tomverbeure/ball/LED_constraints_overview.png

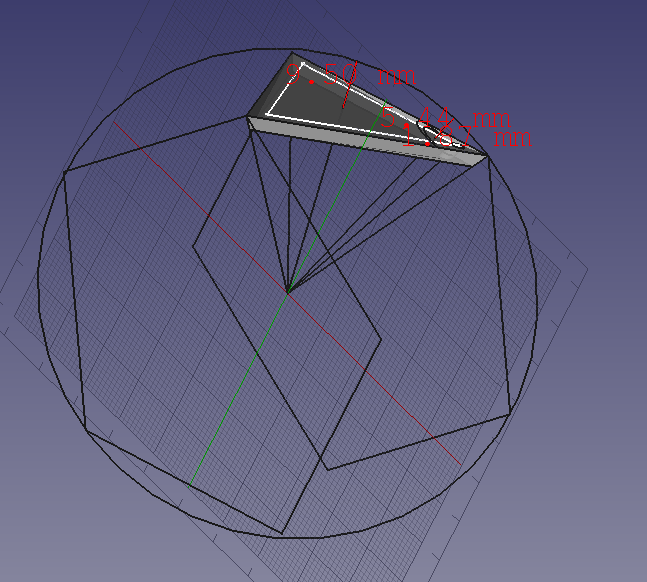
LED_constraints_overview.png
