tomverbeure/ball/LED_height_on_sphere.png

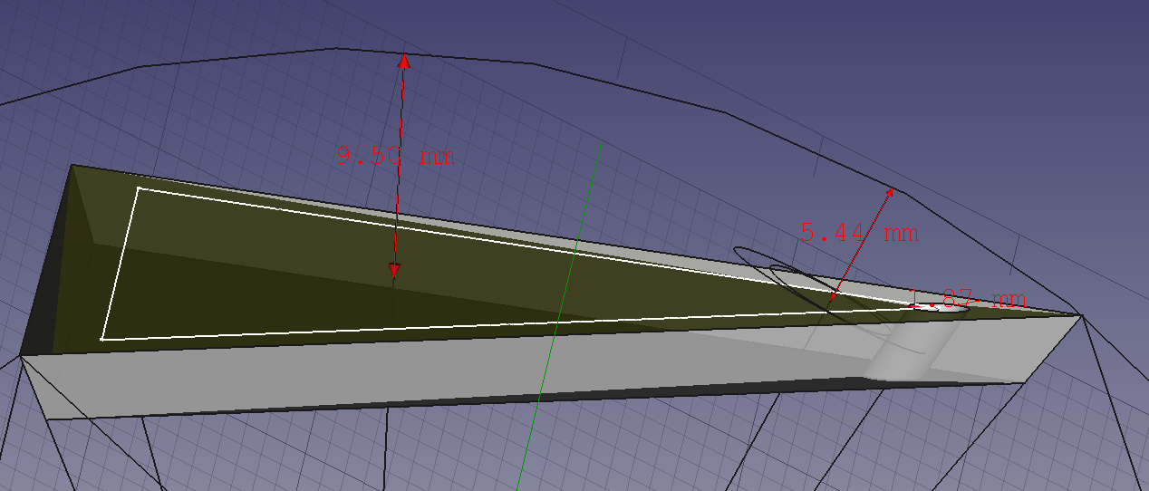
LED_height_on_sphere.png
