tomverbeure/ball/LED_leads_width.png

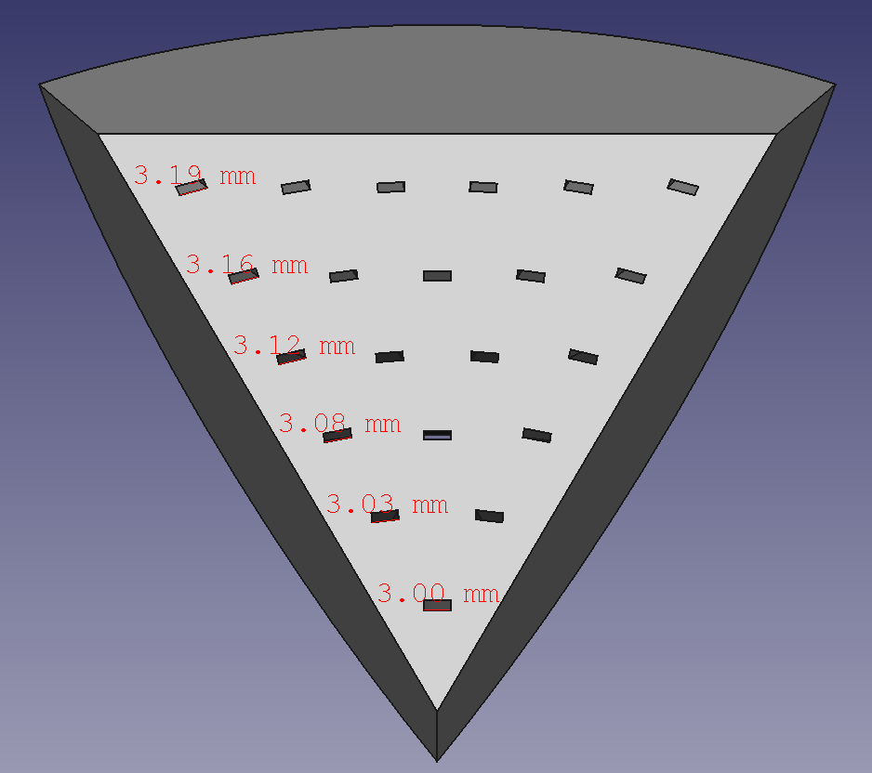
LED_leads_width.png
