tomverbeure/ball/LED_width_on_sphere.png

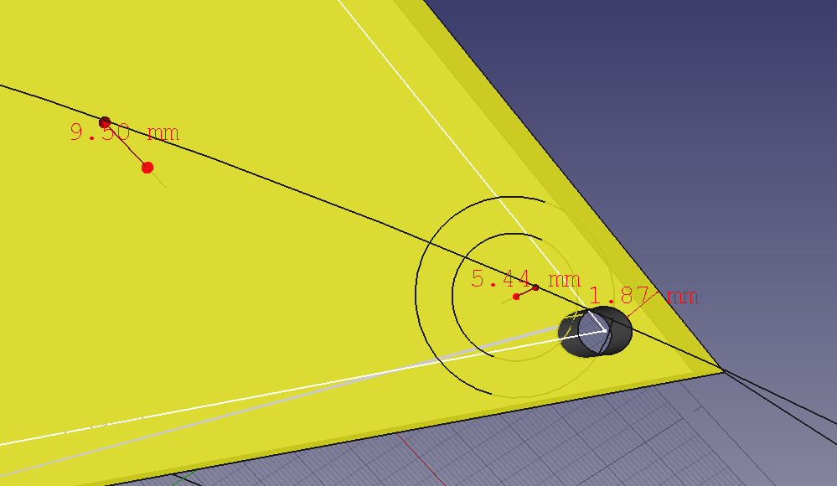
LED_width_on_sphere.png
