tomverbeure/ball/sphere_overall_dimensions.png

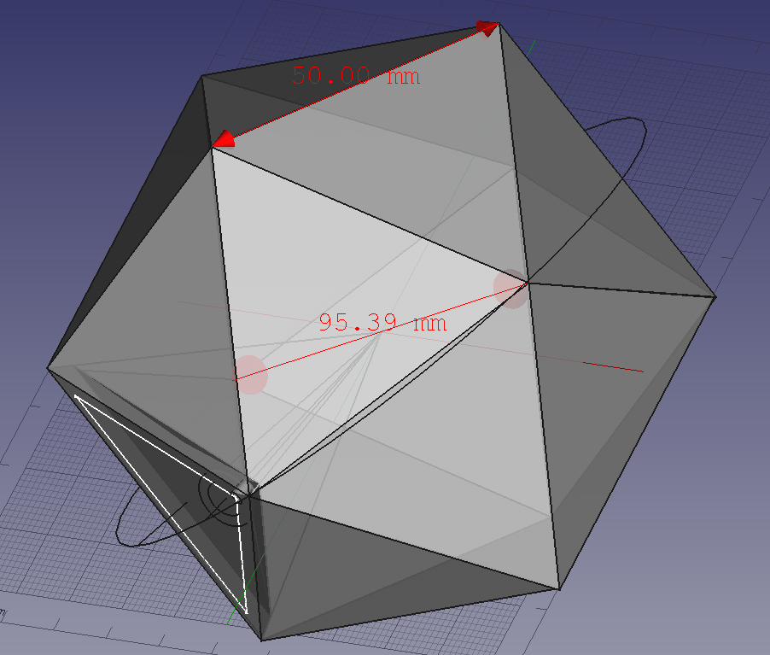
sphere_overall_dimensions.png
