tomverbeure/ball/icosahedron/geodesic_1/assembly2.FCStd

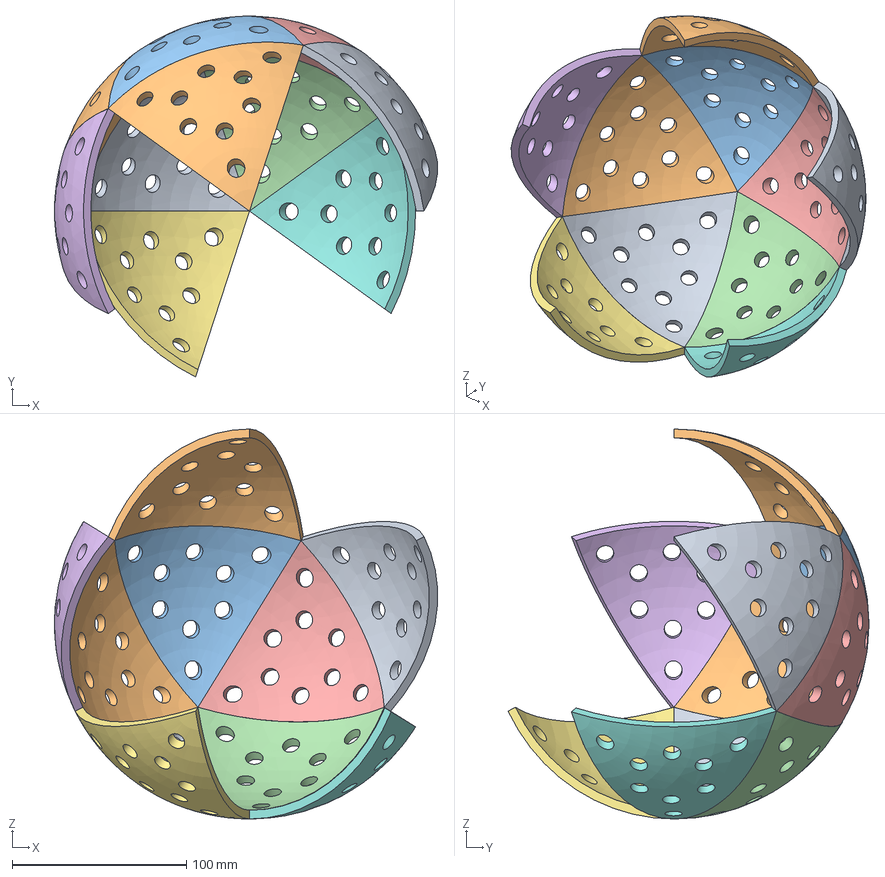
[picture p12: CAD file, 2021-12-22]
icosahedron/geodesic_1/assembly2.FCStd
219.5 x 206.9 x 223.5 mm
test_Body002_001
test_Body002_002
test_Body002_003
test_Body002_004
test_Body002_005
test_Body002_006
test_Body002_007
test_Body002_008
test_Body002_009
test_Body002_010
