tomverbeure/ball/rev1/inner_assembly.FCStd

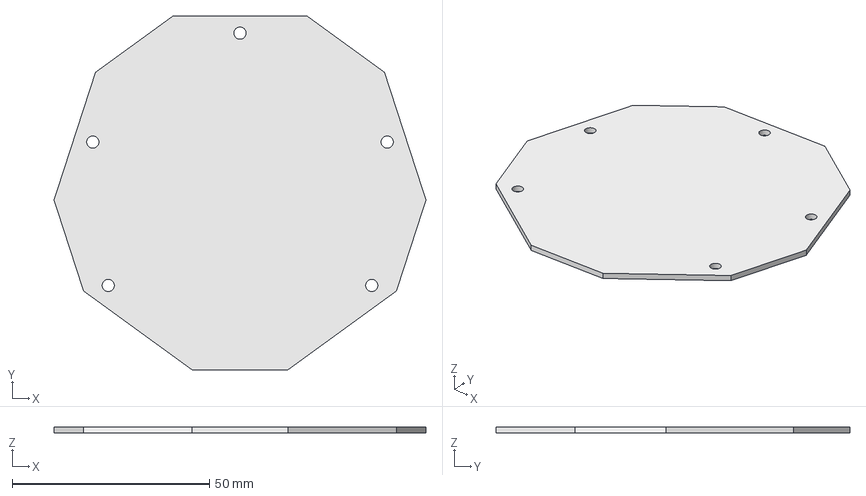
[picture p14: CAD file, 2022-05-01]
rev1/inner_assembly.FCStd
94.4 x 89.8 x 1.60 mm
