tomverbeure/ball/rev1/inner_assembly_PraGa.FCStd

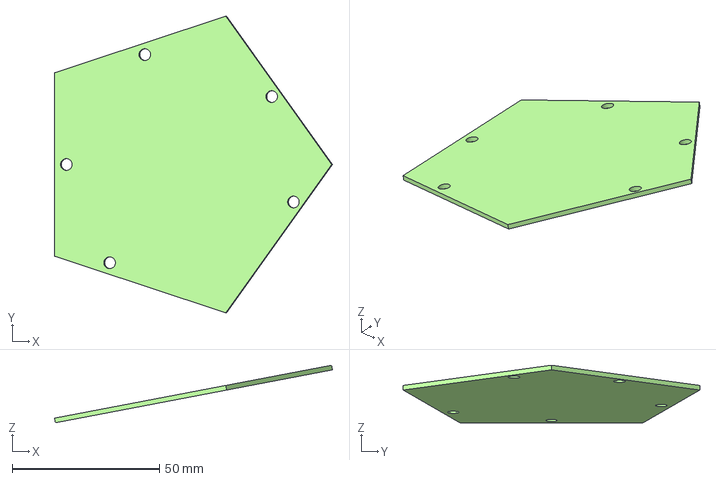
[picture p15: CAD file, 2022-05-01]
rev1/inner_assembly_PraGa.FCStd
94.5 x 100.8 x 19.6 mm
