tomverbeure/ball/icosahedron/Shell_and_PCB_complete.FCStd

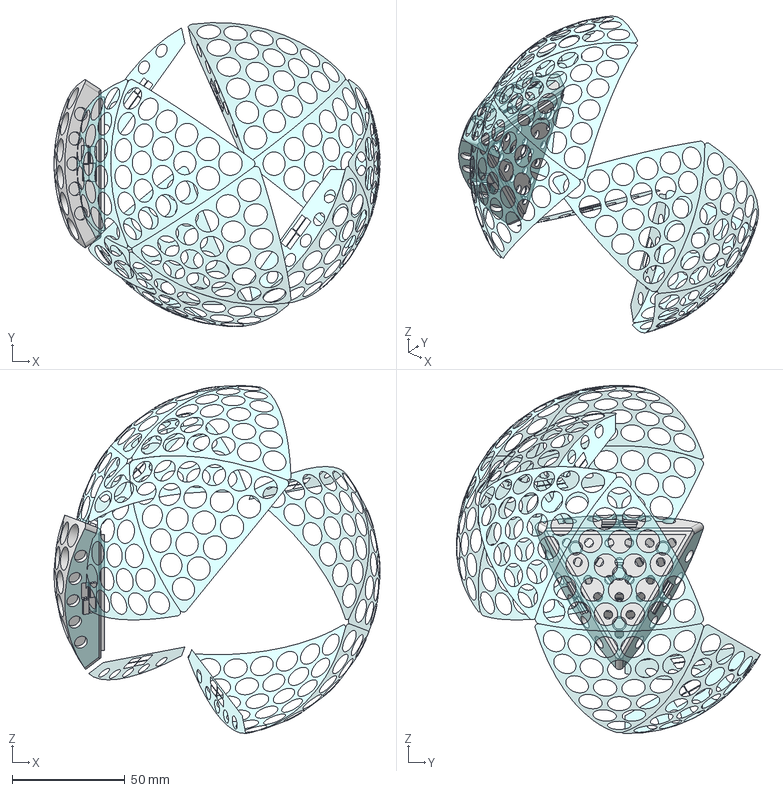
[picture p16: CAD file, 2022-03-06]
icosahedron/Shell_and_PCB_complete.FCStd
144.5 x 134.7 x 154.4 mm
_Element004
_Element005
_Element021
_Element022
_Element023
_Element025
_Element032
_Element040
_Element043
_Element048
_Element053
_Element058
_Element063
_Element064
_Element069
_Element074
_Element079
