tomverbeure/ball/rev1/assembly_a4.FCStd

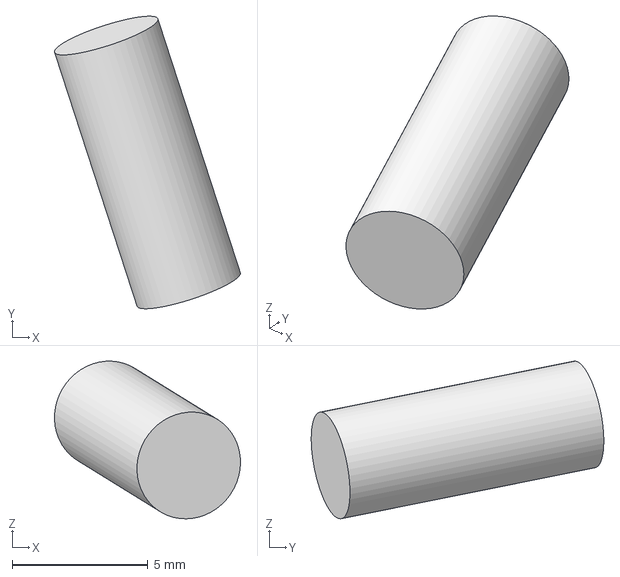
[picture p17: CAD file, 2022-03-27]
rev1/assembly_a4.FCStd
6.84 x 10.8 x 5.80 mm
