tomverbeure/ball/rev1/assembly_a2plus.FCStd

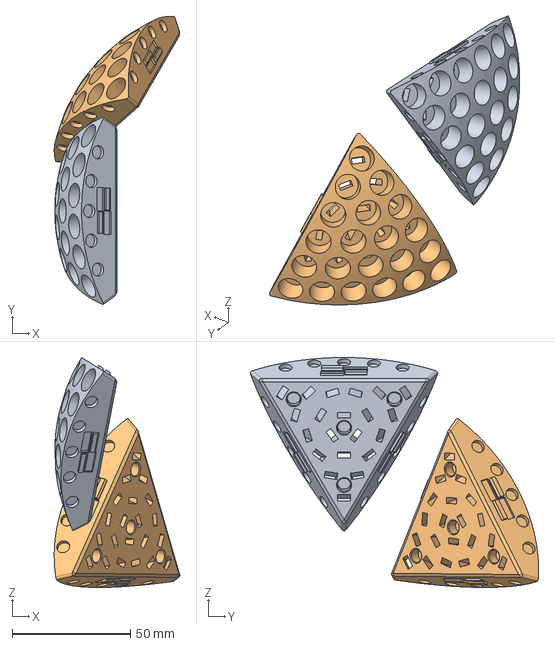
[picture p18: CAD file, 2022-03-27]
rev1/assembly_a2plus.FCStd
53.2 x 122.0 x 97.4 mm
Shell_rev1_001
Shell_rev1_002
