tomverbeure/ball/rev1/ball-1x_shell_full_brim.3mf

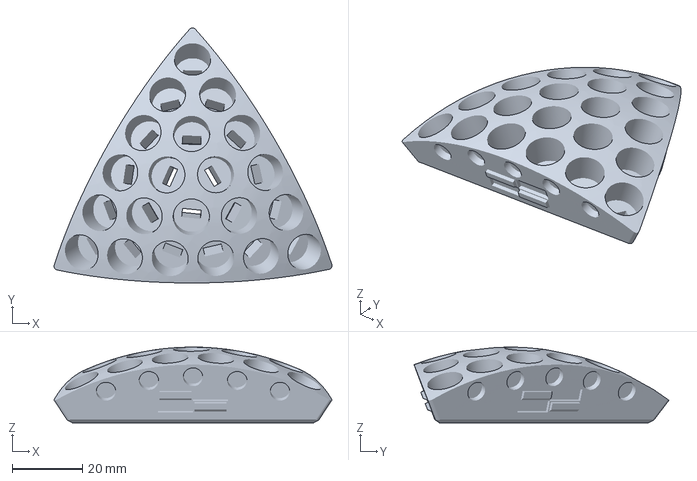
[picture p19: CAD file, 2022-03-27]
rev1/ball-1x_shell_full_brim.3mf
79.4 x 72.8 x 21.6 mm
