tomverbeure/ball/rev1/ball-shell_full.amf

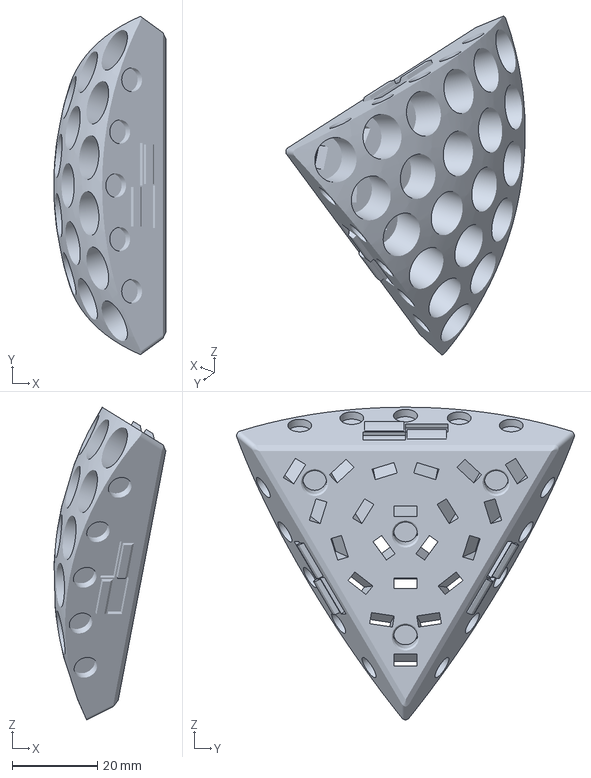
[picture p20: CAD file, 2022-03-13]
rev1/ball-shell_full.amf
26.3 x 79.4 x 73.4 mm
