tomverbeure/ball/rev1/ball-2x_shell_full_brim.3mf

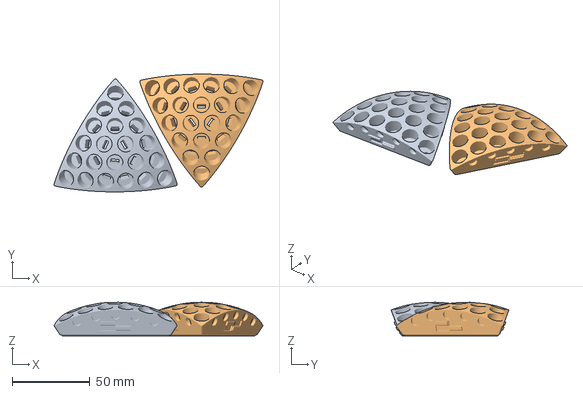
[picture p21: CAD file, 2022-03-13]
rev1/ball-2x_shell_full_brim.3mf
134.6 x 75.9 x 21.6 mm
ball-shell_full.amf
ball-shell_full.amf(1)
