tomverbeure/ball/icosahedron/geodesic_1/test.FCStd

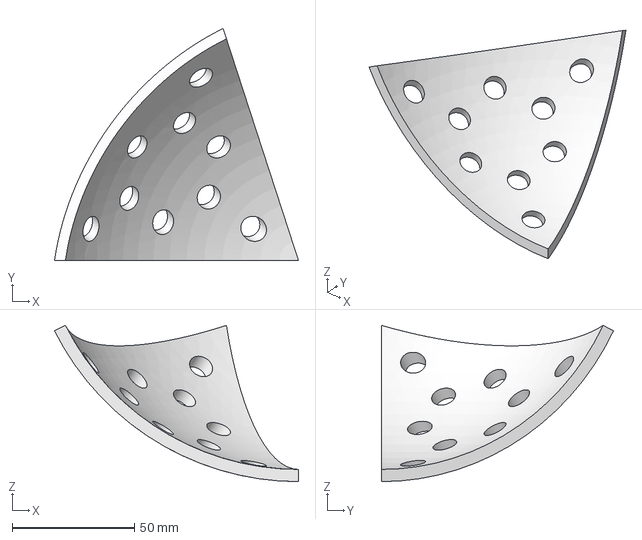
[picture p22: CAD file, 2022-01-08]
icosahedron/geodesic_1/test.FCStd
100.0 x 95.1 x 64.0 mm
