tomverbeure/ball/icosahedron/geodesic_3/test.FCStd

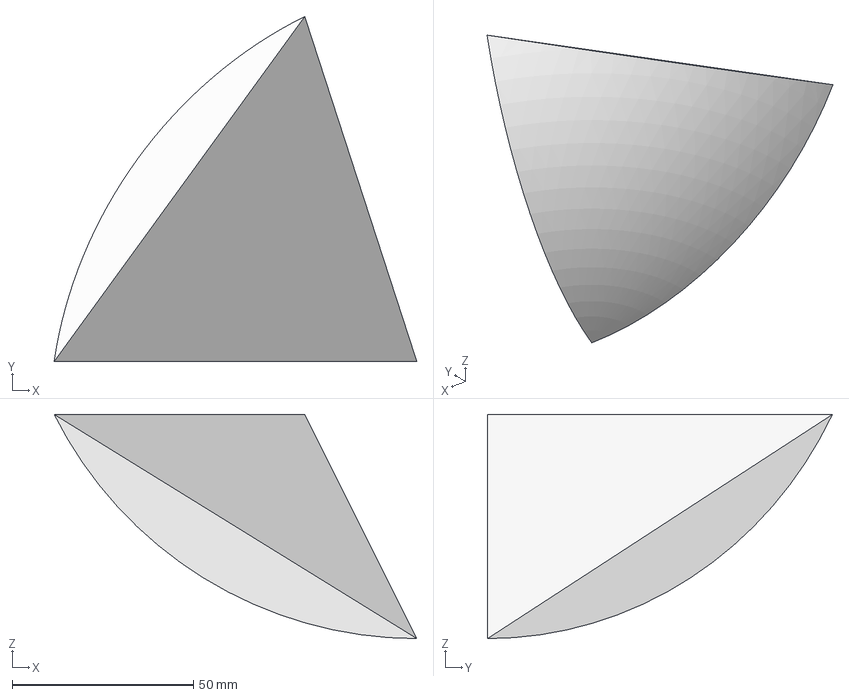
[picture p23: CAD file, 2022-01-08]
icosahedron/geodesic_3/test.FCStd
100.0 x 95.1 x 61.8 mm
