tomverbeure/ball/icosahedron/geodesic_4/frame.FCStd

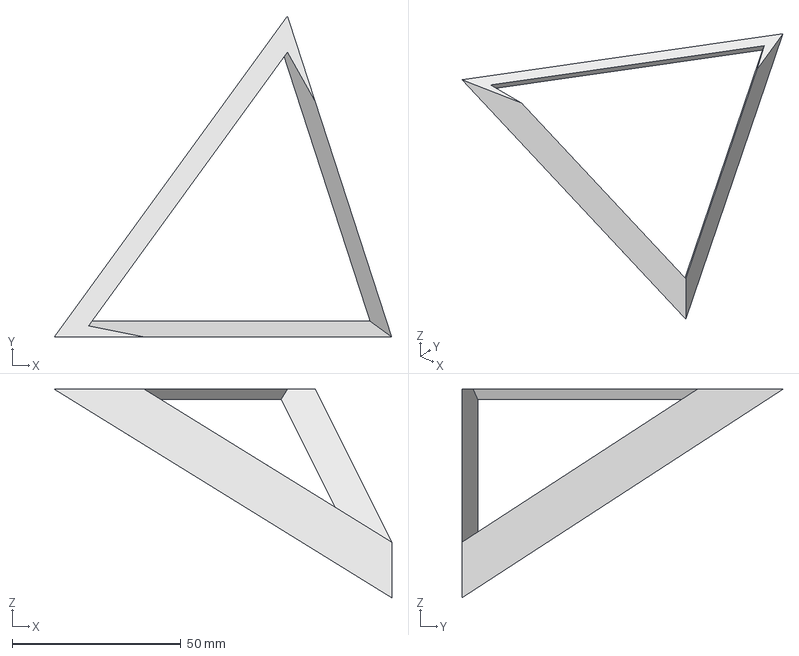
[picture p24: CAD file, 2022-01-08]
icosahedron/geodesic_4/frame.FCStd
100.0 x 95.1 x 61.8 mm
