tomverbeure/ball/icosahedron/geodesic_5/base.FCStd

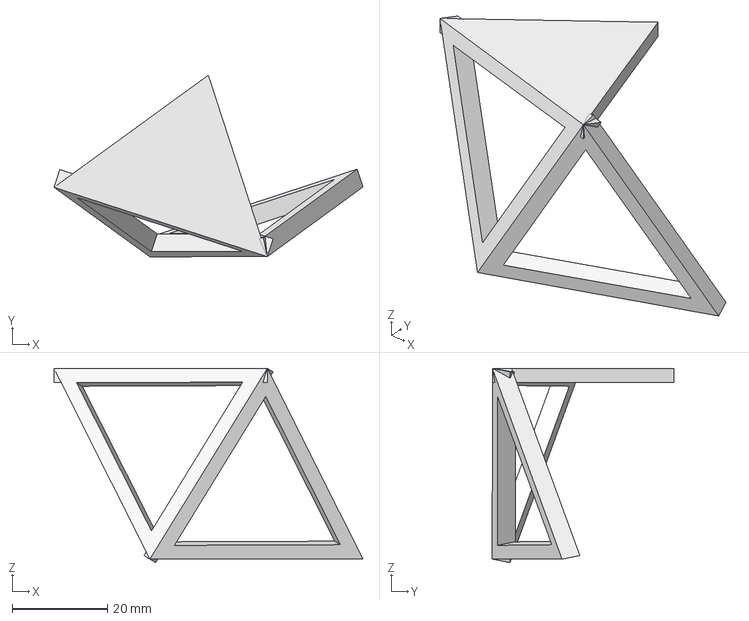
[picture p25: CAD file, 2022-01-08]
icosahedron/geodesic_5/base.FCStd
64.8 x 38.1 x 40.8 mm
