tomverbeure/ball/icosahedron/geodesic_7/base.FCStd

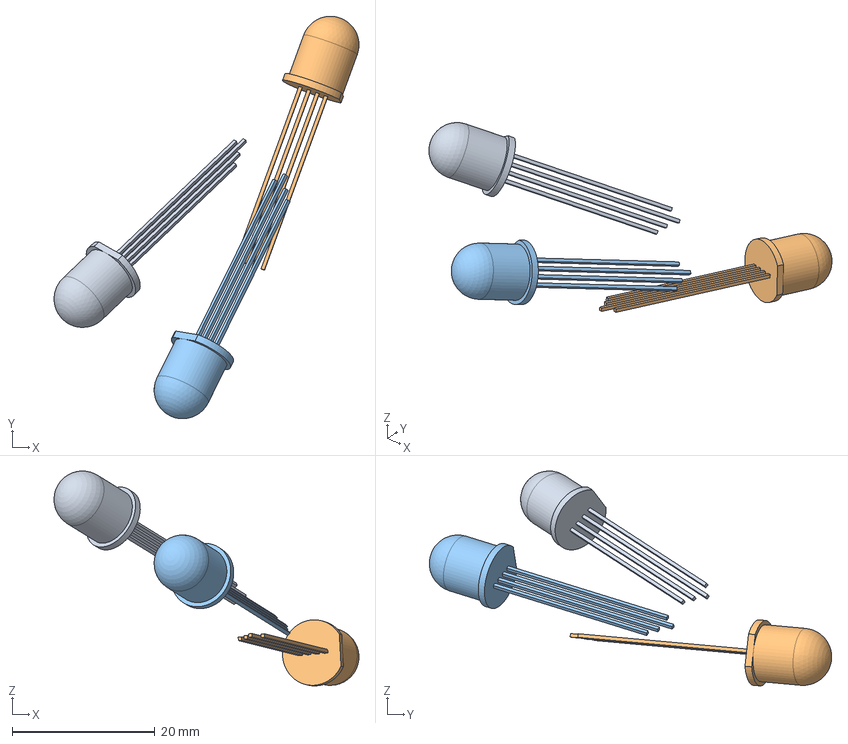
[picture p26: CAD file, 2022-01-18]
icosahedron/geodesic_7/base.FCStd
42.7 x 56.3 x 30.1 mm
LED
LED001
LED002
