tomverbeure/ball/icosahedron/PCB_export.FCStd

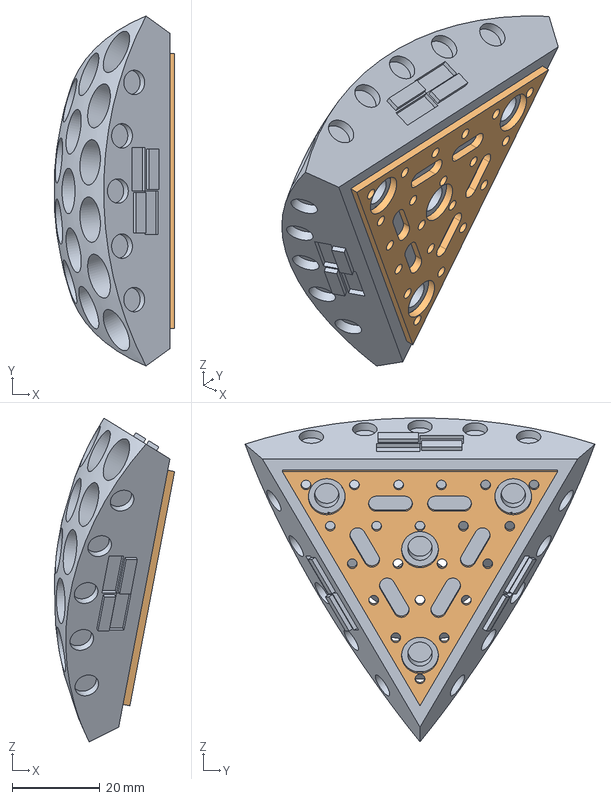
[picture p27: CAD file, 2022-03-27]
icosahedron/PCB_export.FCStd
27.5 x 80.0 x 74.0 mm
