tomverbeure/ball/interlock_trial-BodyPocket002.amf

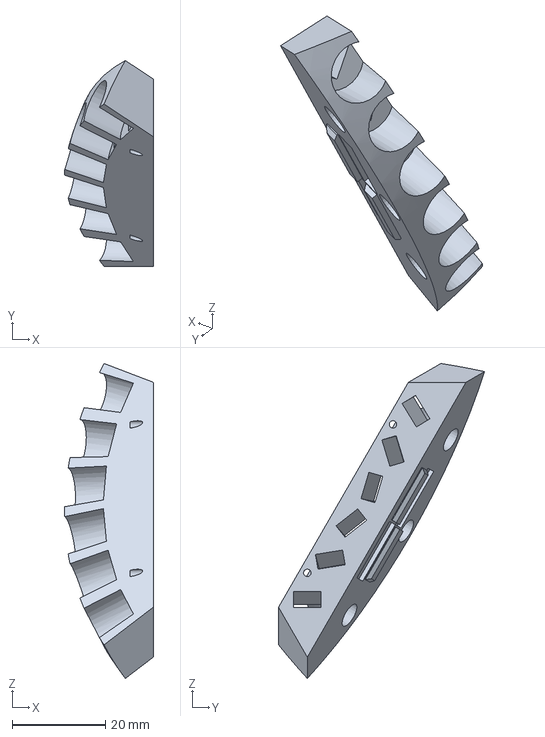
[picture p28: CAD file, 2022-03-03]
interlock_trial-BodyPocket002.amf
19.0 x 44.2 x 67.6 mm
