tomverbeure/ball/pcb/3d_models/leds/ws2812d-f8.FCStd

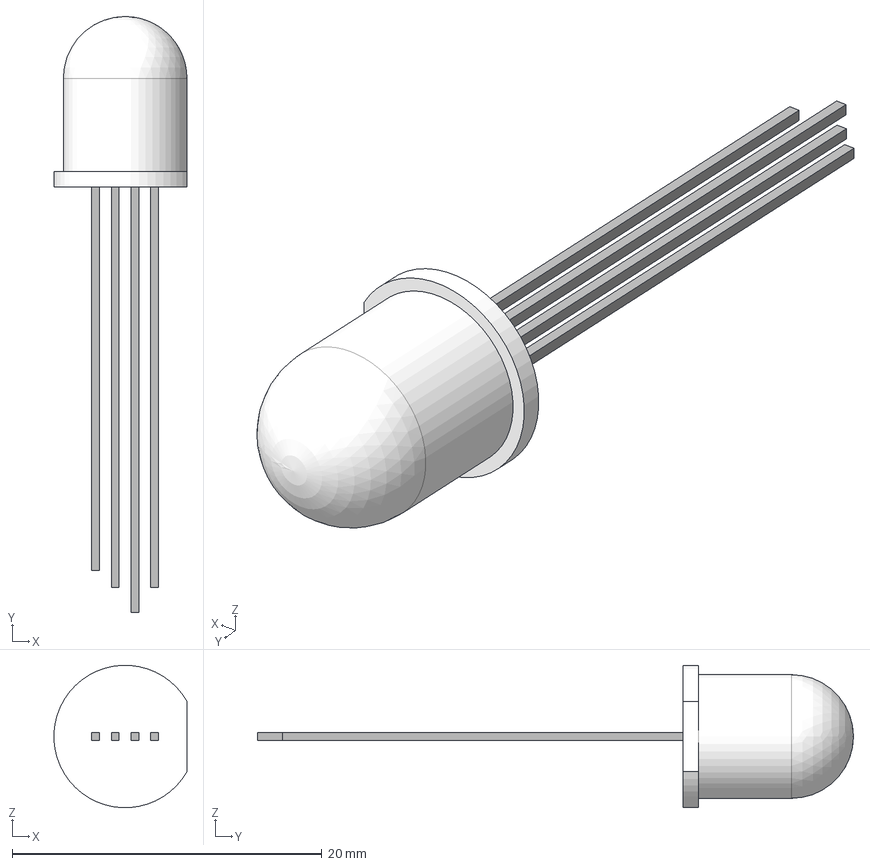
[picture p29: CAD file, 2022-04-16]
pcb/3d_models/leds/ws2812d-f8.FCStd
8.59 x 38.5 x 9.19 mm
led_plastic
lead4
lead3
lead2
lead1
