tomverbeure/ball/pcb/triangle/triangle.step

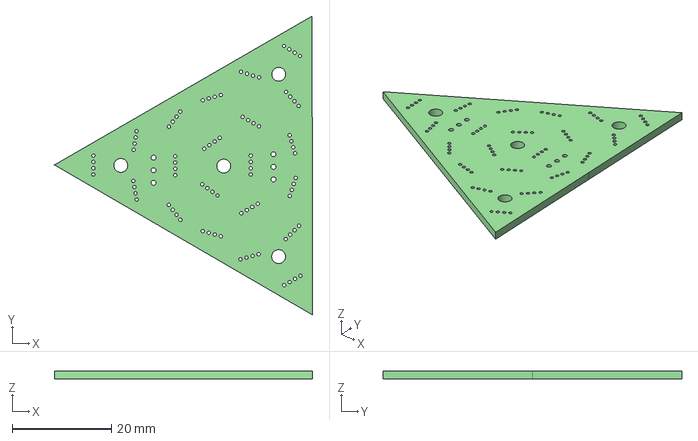
[picture p30: CAD file, 2022-03-03]
pcb/triangle/triangle.step
52.0 x 60.3 x 1.60 mm
