tomverbeure/ball/rev1/Inner_rev3.FCStd

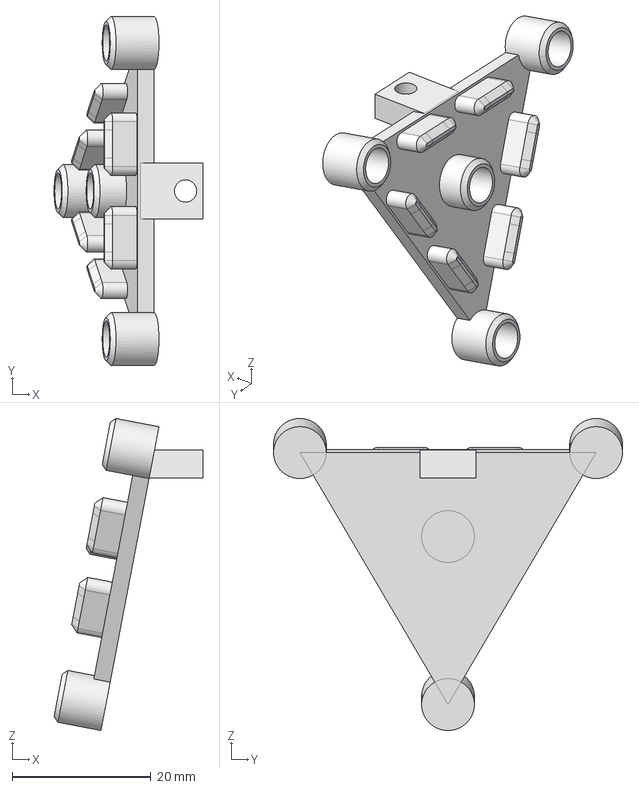
[picture p31: CAD file, 2022-05-01]
rev1/Inner_rev3.FCStd
21.4 x 50.2 x 44.9 mm
