tomverbeure/ball/icosahedron/geodesic_3/test-Body002Box008.amf

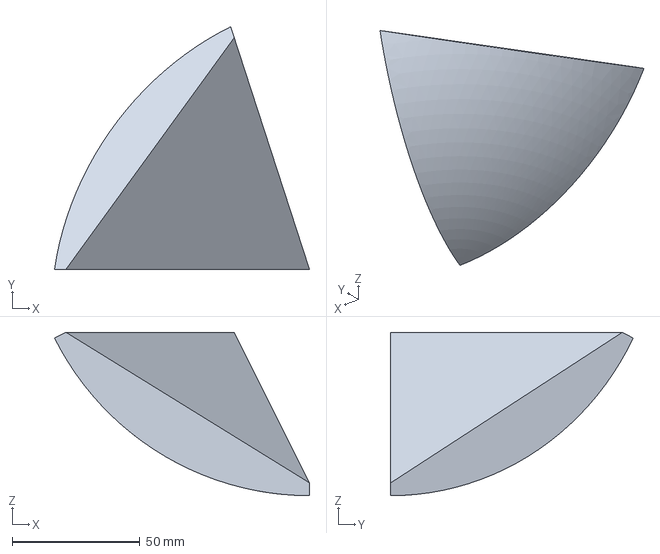
[picture p32: CAD file, 2022-01-08]
icosahedron/geodesic_3/test-Body002Box008.amf
100.0 x 95.1 x 64.1 mm
