tomverbeure/ball/icosahedron/geodesic_6/base.FCStd

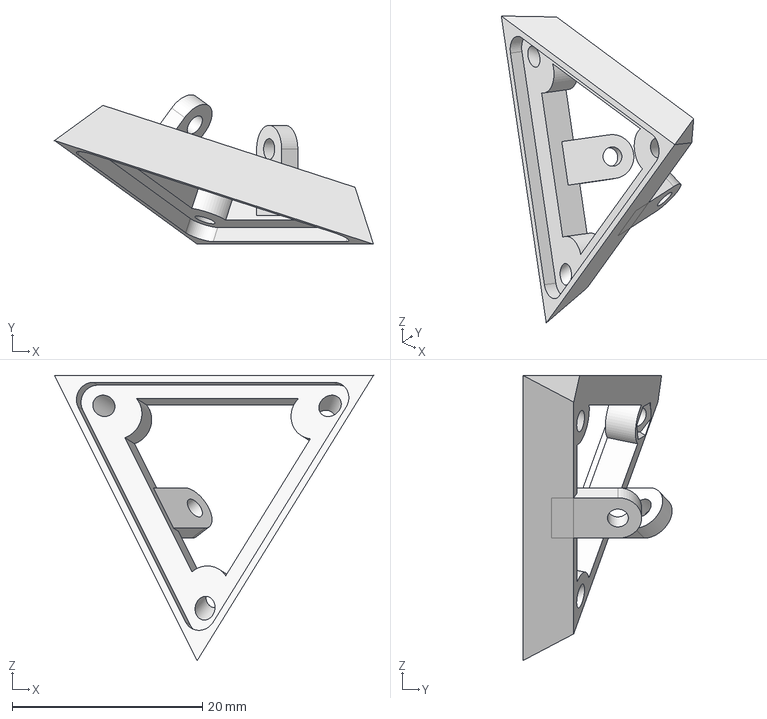
[picture p33: CAD file, 2022-01-10]
icosahedron/geodesic_6/base.FCStd
33.5 x 15.7 x 30.0 mm
