tomverbeure/ball/icosahedron/Shell_and_PCB_battery_test.FCStd

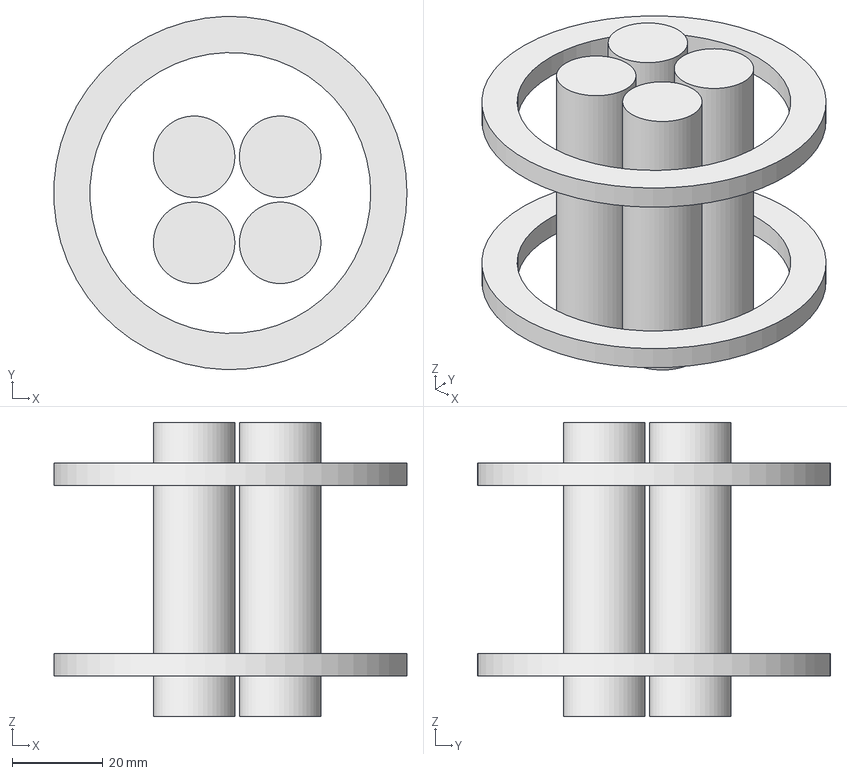
[picture p34: CAD file, 2022-03-08]
icosahedron/Shell_and_PCB_battery_test.FCStd
77.9 x 78.0 x 65.0 mm
Tube
Tube001
