tomverbeure/ball/rev1/ball-inner_center_rev2.amf

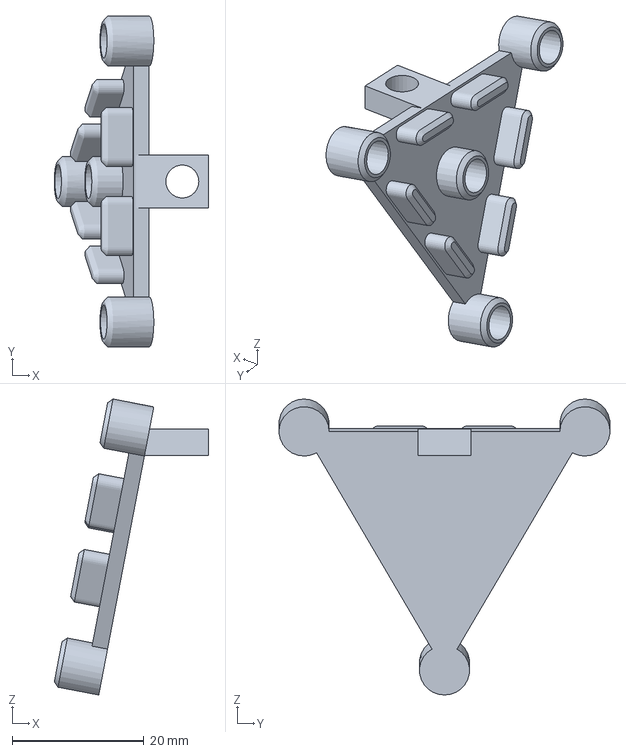
[picture p35: CAD file, 2022-03-30]
rev1/ball-inner_center_rev2.amf
23.4 x 50.2 x 44.9 mm
