tomverbeure/ball/icosahedron/isocahedron_pcb_export.FCStd

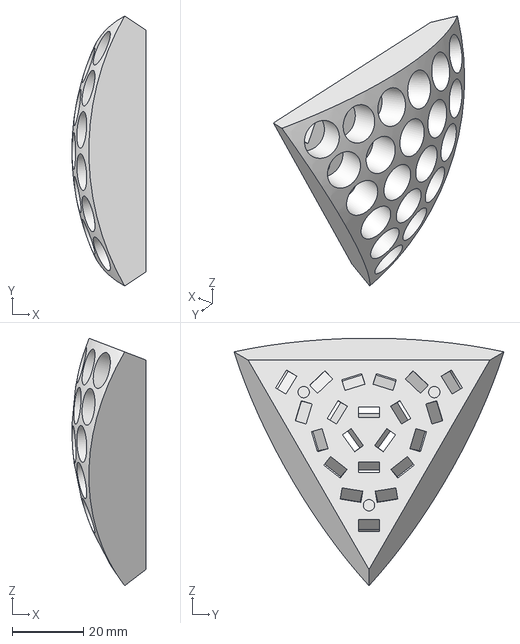
[picture p36: CAD file, 2022-03-03]
icosahedron/isocahedron_pcb_export.FCStd
20.8 x 76.0 x 69.7 mm
