tomverbeure/ball/icosahedron/isocahedron.FCStd

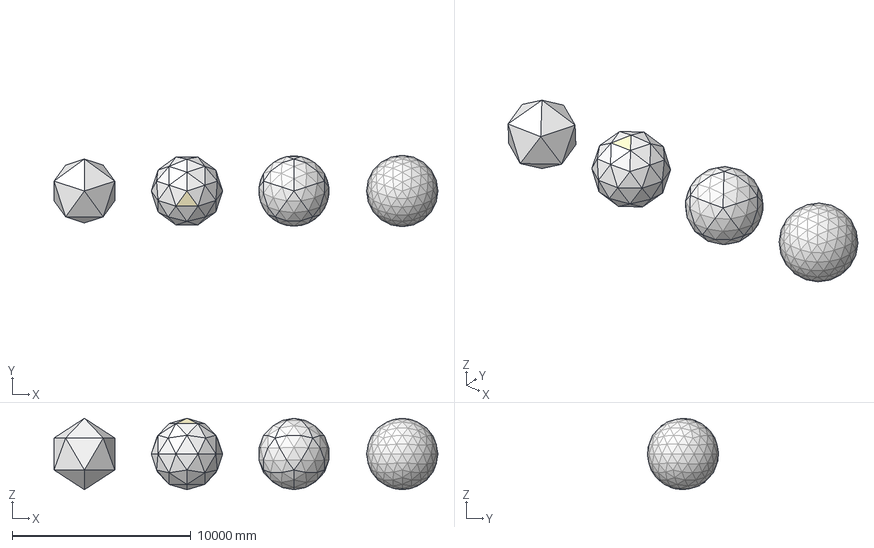
[picture p37: CAD file, 2021-12-22]
icosahedron/isocahedron.FCStd
21483.3 x 4000.0 x 4000.0 mm
GeoDome_80
GeoDome_20
GeoDome_180
GeoDome_320
CopyGeoDome
