tomverbeure/ball/truncated_ico/TruncatedGreatIcosahedron-solid.scad

// source=coordinates form=solid id =TruncatedGreatIcosahedron
solid_1 = TruncatedGreatIcosahedron();
p_describe(solid_1);
scale(20) show_solid(solid_1);

function Z() = TruncatedGreatIcosahedron();
function TruncatedGreatIcosahedron() = 
// source:  http://dmccooey.com/polyhedra/TruncatedGreatIcosahedron.txt
// generated by  http://kitwallace.co.uk/3d/solid-index.xq
let(C0 = 0.118033988749894848204586834366)
let(C1 = 0.309016994374947424102293417183)
let(C2 = 0.618033988749894848204586834366)
let(C3 = 0.690983005625052575897706582817)
let(C4 = 0.927050983124842272306880251548)
poly(name = "Truncated Great Icosahedron",
// 6 sided faces = 20
// 5 sided faces = 12
vertices = [
[ 0.0, -0.5,   C4],
[ 0.0, -0.5,  -C4],
[ 0.0,  0.5,   C4],
[ 0.0,  0.5,  -C4],
[-0.5,   C4,  0.0],
[ 0.5,   C4,  0.0],
[-0.5,  -C4,  0.0],
[ 0.5,  -C4,  0.0],
[  C4,  0.0, -0.5],
[  C4,  0.0,  0.5],
[ -C4,  0.0, -0.5],
[ -C4,  0.0,  0.5],
[  C1, -1.0,   C0],
[  C1, -1.0,  -C0],
[ -C1, -1.0,   C0],
[ -C1, -1.0,  -C0],
[  C1,  1.0,   C0],
[  C1,  1.0,  -C0],
[ -C1,  1.0,   C0],
[ -C1,  1.0,  -C0],
[-1.0,   C0,   C1],
[-1.0,   C0,  -C1],
[ 1.0,   C0,   C1],
[ 1.0,   C0,  -C1],
[-1.0,  -C0,   C1],
[-1.0,  -C0,  -C1],
[ 1.0,  -C0,   C1],
[ 1.0,  -C0,  -C1],
[  C0,   C1, -1.0],
[  C0,   C1,  1.0],
[ -C0,   C1, -1.0],
[ -C0,   C1,  1.0],
[  C0,  -C1, -1.0],
[  C0,  -C1,  1.0],
[ -C0,  -C1, -1.0],
[ -C0,  -C1,  1.0],
[  C2, -0.5,  -C3],
[  C2, -0.5,   C3],
[ -C2, -0.5,  -C3],
[ -C2, -0.5,   C3],
[  C2,  0.5,  -C3],
[  C2,  0.5,   C3],
[ -C2,  0.5,  -C3],
[ -C2,  0.5,   C3],
[-0.5,  -C3,   C2],
[-0.5,  -C3,  -C2],
[ 0.5,  -C3,   C2],
[ 0.5,  -C3,  -C2],
[-0.5,   C3,   C2],
[-0.5,   C3,  -C2],
[ 0.5,   C3,   C2],
[ 0.5,   C3,  -C2],
[ -C3,   C2, -0.5],
[ -C3,   C2,  0.5],
[  C3,   C2, -0.5],
[  C3,   C2,  0.5],
[ -C3,  -C2, -0.5],
[ -C3,  -C2,  0.5],
[  C3,  -C2, -0.5],
[  C3,  -C2,  0.5]],
faces = [
[ 14 , 38, 42, 18,  2,  0],
[ 13 , 37, 41, 17,  3,  1],
[ 16 , 40, 36, 12,  0,  2],
[ 19 , 43, 39, 15,  1,  3],
[ 21 , 45, 47, 23,  5,  4],
[ 22 , 46, 44, 20,  4,  5],
[ 24 , 48, 50, 26,  7,  6],
[ 27 , 51, 49, 25,  6,  7],
[ 32 , 56, 57, 33,  9,  8],
[ 29 , 53, 52, 28,  8,  9],
[ 30 , 54, 55, 31, 11, 10],
[ 35 , 59, 58, 34, 10, 11],
[ 36 , 28, 52, 20, 44, 12],
[ 45 , 21, 53, 29, 37, 13],
[ 46 , 22, 54, 30, 38, 14],
[ 39 , 31, 55, 23, 47, 15],
[ 48 , 24, 56, 32, 40, 16],
[ 41 , 33, 57, 25, 49, 17],
[ 42 , 34, 58, 26, 50, 18],
[ 51 , 27, 59, 35, 43, 19],
[ 12 , 44, 46, 14,  0],
[ 15 , 47, 45, 13,  1],
[ 18 , 50, 48, 16,  2],
[ 17 , 49, 51, 19,  3],
[ 20 , 52, 53, 21,  4],
[ 23 , 55, 54, 22,  5],
[ 25 , 57, 56, 24,  6],
[ 26 , 58, 59, 27,  7],
[ 28 , 36, 40, 32,  8],
[ 33 , 41, 37, 29,  9],
[ 34 , 42, 38, 30, 10],
[ 31 , 39, 43, 35, 11]]
);
/* 
A script to implement the Conway operations and more on Polyhedra.  

By Kit Wallace kit.wallace@gmail.com

with thanks to George Hart whose javascript version http://www.georgehart.com/virtual-polyhedra/conway_notation.html was the inspiration for this work.

Code licensed under the Creative Commons - Attribution - Share Alike license.

The project is being documented in my blog 
   http://kitwallace.tumblr.com/tagged/conway
      
OpenSCAD version 2015-03-01 or later: requires concat, list comprehension and let()
         
Features
    poly object constructor 
    poly accessors and renderers  (as 3d object, description, full print, face and vertex analyses)
    
    primitives T(),C(),O(),D(),I(),Y(n),P(n),A(n)
        all centered and normalized to a mid-scribed radius of 1 
        
   conway/hart operators 
       kis(obj,ratio, nsides)
       ambo(obj)
       meta(obj,ratio)
       ortho(obj,ratio)
       trunc(obj,ratio, nsides) 
       dual(obj)    
       snub(obj,height)
       expand(obj,height), rexpand () to apply recursively 
       reflect(obj)
       gyro(obj)   
       propellor(obj,ratio)
       hexpropello(obj) (Dave Mccooey)
       join(obj)  == dual(ambo(obj)
       bevel(obj) == trunc(ambo(obj))
       chamfer(obj,ratio)
       whirl(obj,ratio)
       quinta(obj)
         
   additional operators, mostly decorative
       tt(obj)   convert triangular faces into 4 triangles
       cc(obj)  - Catmull-Clark smoothing
       transform(obj,matrix)    matrix transformation of vertices
       inset_kis(obj,ratio,height,fn)
       modulate(obj)  with global spherical function fmod()
       openface(obj,outer_inset_ratio,inner_inset_ratio,
            ,outer_inset,inner_inset,height,min_edge_length)
       place(obj)  on largest face -use before openface
       crop(obj,minz,maxz) - then render with wire frame
    orientation, centering and resizing
       p_inscribed_resize_points()  - resize to a given average face centroid
       p_midscribed_resize_points() - resize to a given average edge centroid
       p_circumscribed_resize_points() - resize to a given average vertex
       orient(obj)  - ensure all faces have lhs order (only convex )
         needed for some imported solids eg Georges solids and Johnson
             and occasionally for David's 
    
    canonicalization
       plane(obj,itr) - planarization using reciprocals of face centroids
       canon(obj,itr) - canonicalization using edge tangents
    
    rendering
      p_render(obj,...)
      p_hull(obj,r)
      p_render_text(obj,texts...)
      
    version 2016/04/19
    version 2017/04/09  - quinto added
*/
// seed polyhedra
function T()= 
    p_resize(poly(name= "T",
       vertices= [[1,1,1],[1,-1,-1],[-1,1,-1],[-1,-1,1]],
       faces= [[2,1,0],[3,2,0],[1,3,0],[2,3,1]]
    ));
function C() = 
   p_resize(poly(name= "C",
       vertices= [
[ 0.5,  0.5,  0.5],
[ 0.5,  0.5, -0.5],
[ 0.5, -0.5,  0.5],
[ 0.5, -0.5, -0.5],
[-0.5,  0.5,  0.5],
[-0.5,  0.5, -0.5],
[-0.5, -0.5,  0.5],
[-0.5, -0.5, -0.5]],
      faces=
 [
[ 4 , 5, 1, 0],
[ 2 , 6, 4, 0],
[ 1 , 3, 2, 0],
[ 6 , 2, 3, 7],
[ 5 , 4, 6, 7],
[ 3 , 1, 5, 7]]
   ));

function O() = 
  let (C0 = 0.7071067811865475244008443621048)
  p_resize(poly(name="O",
         vertices=[
[0.0, 0.0,  C0],
[0.0, 0.0, -C0],
[ C0, 0.0, 0.0],
[-C0, 0.0, 0.0],
[0.0,  C0, 0.0],
[0.0, -C0, 0.0]],
        faces= [
[ 4 , 2, 0],
[ 3 , 4, 0],
[ 5 , 3, 0],
[ 2 , 5, 0],
[ 5 , 2, 1],
[ 3 , 5, 1],
[ 4 , 3, 1],
[ 2 , 4, 1]]   
    ));
function D() = 
  let (C0 = 0.809016994374947424102293417183)
  let (C1 =1.30901699437494742410229341718)

  p_resize(poly(name="D",
         vertices=[
[ 0.0,  0.5,   C1],
[ 0.0,  0.5,  -C1],
[ 0.0, -0.5,   C1],
[ 0.0, -0.5,  -C1],
[  C1,  0.0,  0.5],
[  C1,  0.0, -0.5],
[ -C1,  0.0,  0.5],
[ -C1,  0.0, -0.5],
[ 0.5,   C1,  0.0],
[ 0.5,  -C1,  0.0],
[-0.5,   C1,  0.0],
[-0.5,  -C1,  0.0],
[  C0,   C0,   C0],
[  C0,   C0,  -C0],
[  C0,  -C0,   C0],
[  C0,  -C0,  -C0],
[ -C0,   C0,   C0],
[ -C0,   C0,  -C0],
[ -C0,  -C0,   C0],
[ -C0,  -C0,  -C0]],
         faces=[
[ 12 ,  4, 14,  2,  0],
[ 16 , 10,  8, 12,  0],
[  2 , 18,  6, 16,  0],
[ 17 , 10, 16,  6,  7],
[ 19 ,  3,  1, 17,  7],
[  6 , 18, 11, 19,  7],
[ 15 ,  3, 19, 11,  9],
[ 14 ,  4,  5, 15,  9],
[ 11 , 18,  2, 14,  9],
[  8 , 10, 17,  1, 13],
[  5 ,  4, 12,  8, 13],
[  1 ,  3, 15,  5, 13]]
   ));
   
function I() = 
  let(C0 = 0.809016994374947424102293417183)
  p_resize(poly(name= "I",
         vertices= [
[ 0.5,  0.0,   C0],
[ 0.5,  0.0,  -C0],
[-0.5,  0.0,   C0],
[-0.5,  0.0,  -C0],
[  C0,  0.5,  0.0],
[  C0, -0.5,  0.0],
[ -C0,  0.5,  0.0],
[ -C0, -0.5,  0.0],
[ 0.0,   C0,  0.5],
[ 0.0,   C0, -0.5],
[ 0.0,  -C0,  0.5],
[ 0.0,  -C0, -0.5]],
        faces=[
[ 10 ,  2,  0],
[  5 , 10,  0],
[  4 ,  5,  0],
[  8 ,  4,  0],
[  2 ,  8,  0],
[  6 ,  8,  2],
[  7 ,  6,  2],
[ 10 ,  7,  2],
[ 11 ,  7, 10],
[  5 , 11, 10],
[  1 , 11,  5],
[  4 ,  1,  5],
[  9 ,  1,  4],
[  8 ,  9,  4],
[  6 ,  9,  8],
[  3 ,  9,  6],
[  7 ,  3,  6],
[ 11 ,  3,  7],
[  1 ,  3, 11],
[  9 ,  3,  1]]
));


function Y(n,h=1) =
// pyramids
   p_resize(poly(name= str("Y",n) ,
      vertices=
      concat(
        [for (i=[0:n-1])
            [cos(i*360/n),sin(i*360/n),0]
        ],
        [[0,0,h]]
      ),
      faces=concat(
        [for (i=[0:n-1])
            [(i+1)%n,i,n]
        ],
        [[for (i=[0:n-1]) i]]
      )
     ));

function P(n,h=1) =
// prisms
   p_resize(poly(name=str("P",n) ,
      vertices=concat(
        [for (i=[0:n-1])
            [cos(i*360/n),sin(i*360/n),-h/2]
        ],
        [for (i=[0:n-1])
            [cos(i*360/n),sin(i*360/n),h/2]
        ]
      ),
      faces=concat(
        [for (i=[0:n-1])
            [(i+1)%n,i,i+n,(i+1)%n + n]
        ],
        [[for (i=[0:n-1]) i]], 
        [[for (i=[n-1:-1:0]) i+n]]
      )
     ));
        
function A(n,h=1) =
// antiprisms
   p_resize(poly(name=str("A",n) ,
      vertices=concat(
        [for (i=[0:n-1])
            [cos(i*360/n),sin(i*360/n),-h/2]
        ],
        [for (i=[0:n-1])
            [cos((i+1/2)*360/n),sin((i+1/2)*360/n),h/2]
        ]
      ),
      faces=concat(
        [for (i=[0:n-1])
            [(i+1)%n,i,i+n]
        ],
        [for (i=[0:n-1])
            [(i+1)%n,i+n,(i+1)%n + n]
        ],
        
        [[for (i=[0:n-1]) i]], 
        [[for (i=[n-1:-1:0]) i+n]]
      )
     ));

// basic list comprehension functions

function depth(a) =
   len(a)== undef 
       ? 0
       : 1+depth(a[0]);
        
function flatten(l) = [ for (a = l) for (b = a) b ] ;

function dflatten(l,d=2) =
// hack to flattened mixed list and list of lists
   flatten([for (a = l) depth(a) > d ? dflatten(a, d) : [a]]);
    
function reverse(l) = 
     [for (i=[1:len(l)]) l[len(l)-i]];

function shift(l,shift=0) = 
     [for (i=[0:len(l)-1]) l[(i + shift)%len(l)]];  
         
//  functions for creating the matrices for transforming a single point

function m_translate(v) = [ [1, 0, 0, 0],
                            [0, 1, 0, 0],
                            [0, 0, 1, 0],
                            [v.x, v.y, v.z, 1  ] ];

function m_scale(v) =    [ [v.x, 0, 0, 0],
                            [0, v.y, 0, 0],
                            [0, 0, v.z, 0],
                            [0, 0, 0, 1  ] ];
                            
function m_rotate(v) =  [ [1,  0,         0,        0],
                          [0,  cos(v.x),  sin(v.x), 0],
                          [0, -sin(v.x),  cos(v.x), 0],
                          [0,  0,         0,        1] ]
                      * [ [ cos(v.y), 0,  -sin(v.y), 0],
                          [0,         1,  0,        0],
                          [ sin(v.y), 0,  cos(v.y), 0],
                          [0,         0,  0,        1] ]
                      * [ [ cos(v.z),  sin(v.z), 0, 0],
                          [-sin(v.z),  cos(v.z), 0, 0],
                          [ 0,         0,        1, 0],
                          [ 0,         0,        0, 1] ];
                            
function vec3(v) = [v.x, v.y, v.z];
function m_transform(v, m)  = vec3([v.x, v.y, v.z, 1] * m);

function m_rotate_to(normal) = 
      m_rotate([0, atan2(sqrt(pow(normal.x, 2) + pow(normal.y, 2)), normal.z), 0]) 
    * m_rotate([0, 0, atan2(normal.y, normal.x)]);  
    
function m_rotate_from(normal) = 
      m_rotate([0, 0, -atan2(normal.y, normal.x)]) 
    * m_rotate([0, -atan2(sqrt(pow(normal.x, 2) + pow(normal.y, 2)), normal.z), 0]);  
    
function m_to(centre,normal) = 
      m_rotate([0, atan2(sqrt(pow(normal.x, 2) + pow(normal.y, 2)), normal.z), 0]) 
    * m_rotate([0, 0, atan2(normal.y, normal.x)]) 
    * m_translate(centre);   
   
function m_from(centre,normal) = 
      m_translate(-centre)
    * m_rotate([0, 0, -atan2(normal.y, normal.x)]) 
    * m_rotate([0, -atan2(sqrt(pow(normal.x, 2) + pow(normal.y, 2)), normal.z), 0]); 


function m_rotate_about_line(a,v1,v2) =
      m_from(v1,v2-v1)*m_rotate([0,0,a])*m_to(v1,v2-v1);
      
// modules to orient objects for rendering
module orient_to(centre, normal) {   
      translate(centre)
      rotate([0, 0, atan2(normal.y, normal.x)]) //rotation
      rotate([0, atan2(sqrt(pow(normal.x, 2)+pow(normal.y, 2)),normal.z), 0])
      children();
}

// vector functions
function unitv(v)=  v/ norm(v);

function signx (x) =
     x==0 ? 1 : sign(x);
     
function angle_between(u, v, normal) = 
// protection against inaccurate computation
     let (x= unitv(u) * unitv(v))
     let (y = x <= -1 ? -1 :x >= 1 ? 1 : x)
     let (a = acos(y))
     normal == undef
        ? a 
        : signx(normal * cross(u,v)) * a;
     
function vadd(points,v,i=0) =
      i < len(points)
        ?  concat([points[i] + v], vadd(points,v,i+1))
        :  [];

function vsum(points,i=0) =  
      i < len(points)
        ?  (points[i] + vsum(points,i+1))
        :  [0,0,0];
          
function norm2(v) = v.x*v.x+ v.y*v.y + v.z*v.z;

function reciprocal(v) = v/norm2(v);
           
function ssum(list,i=0) =  
      i < len(list)
        ?  (list[i] + ssum(list,i+1))
        :  0;

function vcontains(val,list) =
     search([val],list)[0] != [];
   
function index_of(key, list) =
      search([key],list)[0]  ;

function value_of(key, list) =
      list[search([key],list)[0]][1]  ;

// dictionary shorthand assuming present
function find(key,array) =  array[search([key],array)[0]];

//sort a key value dictionary
function quicksort_kv(kvs) = 
//  kv[0] is the value to sort on,  kv[1] is the object sorted
 len(kvs)>0
     ? let( 
         pivot   = kvs[floor(len(kvs)/2)][0], 
         lesser  = [ for (y = kvs) if (y[0]  < pivot) y ], 
         equal   = [ for (y = kvs) if (y[0] == pivot) y ], 
         greater = [ for (y = kvs) if (y[0]  > pivot) y ] )
          concat( quicksort_kv(lesser), equal, quicksort_kv(greater))
      : [];
  
function count(val, list) =  // number of occurances of val in list
   ssum([for(v= list) v== val ? 1 :0]);
    
function distinct(list,dlist=[],i=0) =  // return only distinct items of d 
      i==len(list)
         ? dlist
         : search(list[i],dlist) != []
             ? distinct(list,dlist,i+1)
             : distinct(list,concat(dlist,list[i]),i+1)
      ;

// points functions
        
function as_points(indexes,points) =
    [for (i=[0:len(indexes)-1])
          points[indexes[i]]
    ]; 

function centroid(points) = 
      vsum(points) / len(points);
    
function vnorm(points) =
     [for (p=points) norm(p)];
      
function average_norm(points) =
       ssum(vnorm(points)) / len(points);

function transform_points(points, matrix) = 
    [for (p=points) m_transform(p, matrix) ] ;
   
// vertex functions
    
function vertex_faces(v,faces) =   // return the faces containing v
     [ for (f=faces) if(v!=[] && search(v,f)) f ];
    
function ordered_vertex_faces(v,vfaces,cface=[],k=0)  =
   k==0
       ? let (nface=vfaces[0])
           concat([nface],ordered_vertex_faces(v,vfaces,nface,k+1))
       : k < len(vfaces)
           ?  let(i = index_of(v,cface))
              let(j= (i-1+len(cface))%len(cface))
              let(edge=[v,cface[j]])
              let(nface=face_with_edge(edge,vfaces))
                 concat([nface],ordered_vertex_faces(v,vfaces,nface,k+1 ))  
           : []
;       
      
function ordered_vertex_edges(v,vfaces,face,k=0)  =
   let(cface=(k==0)? vfaces[0] : face)
   k < len(vfaces)
           ?  let(i = index_of(v,cface))
              let(j= (i-1+len(cface))%len(cface))
              let(edge=[v,cface[j]])
              let(nface=face_with_edge(edge,vfaces))
                 concat([edge],ordered_vertex_edges(v,vfaces,nface,k+1 ))  
           : []
;     
     
function vertex_edges(v,edges) = // return the ordered edges containing v
      [for (e = edges) if(e[0]==v || e[1]==v) e];
                       
// edge functions
          
function distinct_edge(e) = 
     e[0]< e[1]
           ? e
           : reverse(e);
          
function ordered_face_edges(f) =
 // edges are ordered anticlockwise
    [for (j=[0:len(f)-1])
        [f[j],f[(j+1)%len(f)]]
    ];

function all_edges(faces) =
   [for (f = faces)
       for (j=[0:len(f)-1])
          let(p=f[j],q=f[(j+1)%len(f)])
             [p,q] 
   ];

function distinct_face_edges(f) =
    [for (j=[0:len(f)-1])
       let(p=f[j],q=f[(j+1)%len(f)])
          distinct_edge([p,q])
    ];
    
function distinct_edges(faces) =
   [for (f = faces)
       for (j=[0:len(f)-1])
          let(p=f[j],q=f[(j+1)%len(f)])
             if(p<q) [p,q]  // no duplicates
   ];
      
function check_euler(obj) =
     //  E = V + F -2    
    len(p_vertices(obj)) + len(p_faces(obj)) - 2
           ==  len(distinct_edges(obj[2]));

function edge_length(edge,points) =    
    let (points = as_points(edge,points))
    norm(points[0]-points[1]) ;
             
function edge_lengths(edges,points) =
   [ for (edge = edges) 
     edge_length(edge,points)
   ];
 
function tangent(v1,v2) =
   let (d=v2-v1)
   v1 - v2 * (d*v1)/norm2(d);
 
function edge_distance(v1,v2) = sqrt(norm2(tangent(v1,v2)));
 
function face_with_edge(edge,faces) =
     flatten(
        [for (f = faces) 
           if (vcontains(edge,ordered_face_edges(f)))
            f
        ]);

function face_with_edge_index(edge,faces) =
     flatten(
        [for (i = [0:len(faces)-1])
           let(f = faces[i])
           if (vcontains(edge,ordered_face_edges(f)))
           i
        ])[0];
                  
function dihedral_angle(edge,faces,points)=
    let(f0 = face_with_edge(edge,faces),
        f1 = face_with_edge(reverse(edge),faces),
        p0 = as_points(f0,points),
        p1 = as_points(f1,points),
        n0 = normal(p0),
        n1 = normal(p1),
        angle =  angle_between(n0,n1),
        dot=(centroid(p0)-centroid(p1))*n1,
        dihedral = dot < 0 ? 180-angle  : 180 +  angle  
        )
     dihedral;     
   
function dihedral_angle_index(edge,faces,points)=
    let(
        f0 = face_with_edge_index(edge,faces),
        f1 = face_with_edge_index(reverse(edge),faces),
        p0 = as_points(faces[f0],points),
        p1 = as_points(faces[f1],points),
        n0 = normal(p0),
        n1 = normal(p1),
        angle =  angle_between(n0,n1),
        dot=(centroid(p0)-centroid(p1))*n1,
        dihedral = dot < 0 ? 180-angle  : 180 +  angle  
        )
     [dihedral,f0+1,f1+1]; 
         
function dihedral_angle_faces(f0,f1,faces,points)=
    let(p0 = as_points(faces[f0],points),
        p1 = as_points(faces[f1],points),
        n0 = normal(p0),
        n1 = normal(p1),
        angle =  angle_between(n0,n1),
        dot=(centroid(p0)-centroid(p1))*n1,
        dihedral = dot < 0 ? 180-angle  : 180 +  angle  
        )
     dihedral; 

//face functions
function selected_face(face,fn) = 
     fn == [] || (len(fn)==undef ?  len(face)== fn : search(len(face),fn) != []) ;

function orthogonal(v0,v1,v2) =  cross(v1-v0,v2-v1);

function normal(face) =
     let (n=orthogonal(face[0],face[1],face[2]))
     - n / norm(n);

function triangle(a,b) = norm(cross(a,b))/2;

function face_area(face) =
     ssum([for (i=[0:len(face)-1])
           triangle(face[i], face[(i+1)%len(face)]) ]);
     
function face_areas(obj) =
   [for (f=p_faces(obj))
       let(face_points = as_points(f,p_vertices(obj)))
       let(centroid=centroid(face_points))
          face_area(vadd(face_points,-centroid))
   ];

function face_areas_index(obj) =
   [for (face=p_faces(obj))
       let(face_points = as_points(face,p_vertices(obj)))
       let(centroid=centroid(face_points))
          [face,face_area(vadd(face_points,-centroid))]
   ];

function max_area(areas, max=[undef,0], i=0) =
   i <len(areas)
      ? areas[i][1] > max[1]
         ?  max_area(areas,areas[i],i+1)
         :  max_area(areas,max,i+1)
      : max[0];

function average_face_normal(fp) =
     let(fl=len(fp))
     let(normals=
           [for(i=[0:fl-1])
            orthogonal(fp[i],fp[(i+1)%fl],fp[(i+2)%fl])
           ]
          )
     vsum(normals)/len(normals);
    
function average_normal(fp) =
     let(fl=len(fp))
     let(unitns=
           [for(i=[0:fl-1])
            let(n=orthogonal(fp[i],fp[(i+1)%fl],fp[(i+2)%fl]))
            let(normn=norm(n))
              normn==0 ? [] : n/normn
           ]
          )
     vsum(unitns)/len(unitns);
     
function average_edge_distance(fp) =
     let(fl=len(fp))
     ssum( [for (i=[0:fl-1])
                edge_distance(fp[i],fp[(i+1)%fl])
             ])/ fl;
    
function face_sides(faces) =
    [for (f=faces) len(f)];
        
function face_coplanarity(face) =
       norm(cross(cross(face[1]-face[0],face[2]-face[1]),
                  cross(face[2]-face[1],face[3]-face[2])
            ));

function face_edges(face,points) =
     [for (edge=ordered_face_edges(face)) 
           edge_length(edge,points)
     ];
         
function min_edge_length(face,points) =
    min(face_edges(face,points));
   
function face_irregularity(face,points) =
    let (lengths=face_edges(face,points))
    max(lengths)/ min(lengths);

function face_analysis(faces) =
  let (edge_counts=face_sides(faces))
  [for (sides=distinct(edge_counts))
        [sides,count(sides,edge_counts)]
   ];

function vertex_face_list(vertices,faces) =
    [for (i=[0:len(vertices)-1])
     let (vf= vertex_faces(i,faces))
     len(vf)];
    
function vertex_analysis(vertices,faces) =
  let (face_counts=vertex_face_list(vertices,faces))
  [for (vo = distinct(face_counts))
        [vo,count(vo,face_counts)]
   ];
// ensure that all faces have a lhs orientation
function cosine_between(u, v) =(u * v) / (norm(u) * norm(v));

function lhs_faces(faces,vertices) =
    [for (face = faces)
     let(points = as_points(face,vertices))
        cosine_between(normal(points), centroid(points)) < 0
        ?  reverse(face)  :  face
    ];
  
// poly functions
//  constructor
function poly(name,vertices,faces,debug=[],partial=false) = 
    [name,vertices,faces,debug,partial];
    
// accessors
function p_name(obj) = obj[0];
function p_vertices(obj) = obj[1];
function p_faces(obj) = obj[2];
function p_debug(obj)=obj[3];
function p_partial(obj)=obj[4];
function p_edges(obj) = 
       p_partial(obj)
           ? all_edges(p_faces(obj))
           : distinct_edges(p_faces(obj));
function p_description(obj) =
    str(p_name(obj),
         ", ",str(len(p_vertices(obj)), " Vertices " ),
         vertex_analysis(p_vertices(obj), p_faces(obj)),
         ", ",str(len(p_faces(obj))," Faces "),
         face_analysis(p_faces(obj)),
         " ",str(len(p_non_planar_faces(obj))," not planar"),
          ", ",str(len(p_edges(obj))," Edges ")
     ); 
     
function p_faces_as_points(obj) =
    [for (f = p_faces(obj))
        as_points(f,p_vertices(obj))
    ];
    
function p_non_planar_faces(obj,tolerance=0.001) =
     [for (face = p_faces(obj))
         if (len(face) >3)
             let (points = as_points(face,p_vertices(obj)))
             let (error=face_coplanarity(points))
             if (error>tolerance) 
                 [tolerance,face]
     ];

function p_dihedral_angles(obj) =
     [for (edge=p_edges(obj))
         dihedral_angle(edge, p_faces(obj),p_vertices(obj))
     ];     
function p_irregular_faces(obj,tolerance=0.01) =
     [for (face = p_faces(obj))
         let(ir=face_irregularity(face,p_vertices(obj)))
         if(abs(ir-1)>tolerance)
               [ir,face]
      ];
             
function p_vertices_to_faces(obj)=
    [for (vi = [0:len(p_vertices(obj))-1])    // each old vertex creates a new face, with 
       let (vf=vertex_faces(vi,p_faces(obj)))   // vertex faces in left-hand order    
       [for (of = ordered_vertex_faces(vi,vf))
              index_of(of,p_faces(obj))    
       ]
    ];
       
module show_points(obj,r=0.1) {
    for (point=p_vertices(obj))
        if (point != [])   // ignore null points
           translate(point) sphere(r);
};

module show_edge(edge, r) {
    p0 = edge[0]; 
    p1 = edge[1];
    hull() {
       translate(p0) sphere(r);
       translate(p1) sphere(r);
    } 
};

module show_edges(obj,r=0.1) {
    for (edge = p_edges(obj))
        show_edge(as_points(edge, p_vertices(obj)), r); 
};

module show_solid(obj) {
    polyhedron(p_vertices(obj),p_faces(obj),convexity=10);
};
       
module p_render(obj,show_vertices=false,show_edges=false,show_faces=true, rv=0.04, re=0.02) {
     if(show_faces) 
          show_solid(obj);
     if(show_vertices) 
          show_points(obj,rv);
     if(show_edges)
          show_edges(obj,re);
};

module p_hull(obj,r=0.01){
  hull() {
      for (p=p_vertices(obj))
          translate(p) sphere(r);    
  }
};
   
module p_describe(obj){
    echo(p_description(obj));
}

module p_print(obj) {
    p_describe(obj);
    echo(" Vertices " ,p_vertices(obj));
    echo(" Faces ", p_faces(obj));
    edges=p_edges(obj);
    echo(str(len(edges)," Edges ",edges));
    non_planar=p_non_planar_faces(obj);
    echo(str(len(non_planar)," faces are not planar", non_planar));
    debug=p_debug(obj);
    if(debug!=[]) echo("Debug",debug);
};

// centering and resizing
        
function centroid_points(points) = 
     vadd(points, - centroid(points));
        
function p_inscribed_resize(obj,radius=1) =
    let(pv=centroid_points(p_vertices(obj)))
    let (centroids= [for (f=p_faces(obj))
                       norm(centroid(as_points(f,pv)))
                      ])
    let (average = ssum(centroids) / len(centroids))
    poly(name=p_name(obj),
         vertices = pv * radius /average,
         faces=p_faces(obj),
         debug=centroids
         );

function p_midscribed_resize(obj,radius=1) =
    let(pv=centroid_points(p_vertices(obj)))
    let(centroids= [for (e=p_edges(obj))
                    let (ep = as_points(e,pv))
                    norm((ep[0]+ep[1])/2)
                   ])
    let (average = ssum(centroids) / len(centroids))
    poly(name=p_name(obj),
         vertices = pv * radius /average,
         faces=p_faces(obj),
         debug=centroids
         );

function p_circumscribed_resize(obj,radius=1) =
    let(pv=centroid_points(p_vertices(obj)))
    let(average=average_norm(pv))
    poly(name=p_name(obj),
         vertices=pv * radius /average,
         faces=p_faces(obj),
         debug=average
    );
 
function p_resize(obj,radius=1) =
    p_circumscribed_resize(obj,radius);

// canonicalization

function rdual(obj) =
    let(np=p_vertices(obj))
    poly(name=p_name(obj),
           vertices =
                [ for (f=p_faces(obj))
                  let (c=centroid(as_points(f,np)))
                     reciprocal(c)
                ]
           ,
           faces= p_vertices_to_faces(obj)  
           );
          
function plane(obj,n=10) = 
    n > 0 
       ? plane(rdual(rdual(obj)),n-1)   
       : p_resize(poly(name=str("K",p_name(obj)),
              vertices=p_vertices(obj),
              faces=p_faces(obj)
             ));

function ndual(obj) =
      let(np=p_vertices(obj))
      poly(name=p_name(obj),
           vertices = 
                [ for (f=p_faces(obj))
                  let (fp=as_points(f,np),
                       c=centroid(fp),
                       n=average_normal(fp),
                       cdotn = c*n,
                       ed=average_edge_distance(fp))
                  reciprocal(n*cdotn) * (1+ed)/2
                ]
           ,  
           faces= p_vertices_to_faces(obj)        
           );
                
function canon(obj,n=10) = 
    n > 0 
       ? canon(ndual(ndual(obj)),n-1)   
       : p_resize(poly(name=str("N",p_name(obj)),
              vertices=p_vertices(obj),
              faces=p_faces(obj)
             ));   
             
function dual(obj) =
    poly(name=str("d",p_name(obj)),
         vertices = 
              [for (f = p_faces(obj))
               let(fp=as_points(f,p_vertices(obj)))
                 centroid(fp)  
              ],
         faces= p_vertices_to_faces(obj)        
        )
;  // end dual
              
// Conway operators 
/*  where necessary, new vertices are first created and stored in an associative array, keyed by whatever is appropriate to identify the new vertex - this could be an old vertex id, a face, an edge or something more complicated.  This array is then used to create an associative array of key and vertex ids for use in face construction, and to generate the new vertices themselves. 
*/

function vertex_ids(entries,offset=0,i=0) = 
// to get position of new vertices 
    len(entries) > 0
          ?[for (i=[0:len(entries)-1]) 
             [entries[i][0] ,i+offset]
           ]
          :[]
          ;
   
function vertex_values(entries)= 
    [for (e = entries) e[1]];
 
function vertex(key,entries) =   // key is an array 
    entries[search([key],entries)[0]][1];
    
// operators
function kis(obj,fn=[],h=0,regular=false) =
// kis each n-face is divided into n triangles which extend to the face centroid
// existimg vertices retained
              
   let(pf=p_faces(obj),
       pv=p_vertices(obj))
   let(newv=   // new centroid vertices    
        [for (f=pf)
         if (selected_face(f,fn) && ( !regular || abs(face_irregularity(f,pv) - 1.0) <0.1))                      
             let(fp=as_points(f,pv))
             [f,centroid(fp) + normal(fp) * h]    // centroid + a bit of normal
        ]) 
   let(newids=vertex_ids(newv,len(pv)))
   let(newf=
       flatten(
         [for (f=pf)                   
            //replace face with triangles
             let(centroid=vertex(f,newids))
             centroid != undef
               ? [for (j=[0:len(f)-1])           
                 let(a=f[j],
                     b=f[(j+1)%len(f)])    
                  [a,b,centroid]
                ]
              : [f]                              // original face
         ]) 
        )         
  
   poly(name=str("k",p_name(obj)),
       vertices= concat(pv, vertex_values(newv)) , 
       faces=newf
   )
; // end kis

function gyro(obj, r=0.3333, h=0.2) = 
// retain original vertices, add face centroids and directed edge points 
//  each N-face becomes N pentagons
    let(pf=p_faces(obj),
        pv=p_vertices(obj),
        pe=p_edges(obj))
    let(newv= 
          concat(
           [for (face=pf)  // centroids
            let(fp=as_points(face,pv))
             [face,centroid(fp) + normal(fp) * h]    // centroid + a bit of normal
           ] ,
           flatten(      //  2 points per edge
              [for (edge = pe)                 
               let (ep = as_points(edge,pv))
                   [ [ edge,  ep[0]+ r *(ep[1]-ep[0])],
                     [ reverse(edge),  ep[1]+ r *(ep[0]-ep[1])]
                   ]
               ]         
           ) 
          ))
    let(newids=vertex_ids(newv,len(pv)))
    let(newf=
         flatten(                        // new faces are pentagons 
         [for (face=pf)   
             [for (j=[0:len(face)-1])
                let (a=face[j],
                     b=face[(j+1)%len(face)],
                     z=face[(j-1+len(face))%len(face)],
                     eab=vertex([a,b],newids),
                     eza=vertex([z,a],newids),
                     eaz=vertex([a,z],newids),
                     centroid=vertex(face,newids))                   
                [a,eab,centroid,eza,eaz]  
            ]
         ]
       )) 
               
    poly(name=str("g",p_name(obj)),
      vertices=  concat(pv, vertex_values(newv)),
      faces= newf
      )
; // end gyro

            
function meta(obj,h=0.1) =
// each face is replaced with 2n triangles based on edge midpoint and centroid
    let(pe=p_edges(obj),
        pf=p_faces(obj),
        pv=p_vertices(obj))
    let (newv =concat(
           [for (face = pf)               // new centroid vertices
            let (fp=as_points(face,pv))
             [face,centroid(fp) + normal(fp)*h]                                
           ],
           [for (edge=pe)
            let (ep = as_points(edge,pv))
            [edge,(ep[0]+ep[1])/2]
           ]))
     let(newids=vertex_ids(newv,len(pv)))
          
     let(newf =
          flatten(
          [for (face=pf) 
             let(centroid=vertex(face,newids))  
             flatten(
              [for (j=[0:len(face)-1])    //  replace face with 2n triangle 
               let (a=face[j],
                    b=face[(j+1)%len(face)],
                    mid=vertex(distinct_edge([a,b]),newids))
                 [ [ mid, centroid, a],
                    [b,centroid, mid] ]  
                 ] )
         ])
      )   
               
     poly(name=str("m",p_name(obj)),
          vertices= concat(pv,vertex_values(newv)),                
          faces=newf
      ) 
 ; //end meta


function cc(obj) =
// Catmull-Clark smoothing
// each face is replaced with n quadralaterals based on edge midpoints vertices and centroid
// edge midpoints are average of edge endpoints and adjacent centroids
// original vertices replaced by weighted average of original vertex, face centroids and edge midpoints

    let(pe=p_edges(obj),
        pf=p_faces(obj),
        pv=p_vertices(obj))
    let (newfv =
           [for (face = pf)               // new centroid vertices
            let (fp=as_points(face,pv))
             [face,centroid(fp)]                                
           ])
    let (newev =                          // new edge 'midpoints'
           [for (edge=pe)
            let (ep = as_points(edge,pv),
                 af1 = face_with_edge(edge,pf),
                 af2 = face_with_edge(reverse(edge),pf),
                 fc1 = vertex(af1, newfv),
                 fc2 = vertex(af2, newfv))
             [edge,(ep[0]+ep[1]+fc1+fc2)/4]
           ])
     let(newfvids=vertex_ids(newfv,len(pv)))
     let(newevids=vertex_ids(newev,len(pv)+len(newfv)))
         
     let(newf =
          flatten(
          [for (face=pf) 
             let(centroid=vertex(face,newfvids))  
             flatten(
              [for (j=[0:len(face)-1])    //  
               let (a=face[j],
                    b=face[(j+1)%len(face)],
                    c=face[(j+2)%len(face)],
                    mid1=vertex(distinct_edge([a,b]),newevids),
                    mid2=vertex(distinct_edge([b,c]),newevids)         
              )
                   [[ centroid, mid1,b,mid2]]
              ])
           ]))   
     let(newv =                       // revised original vertices 
         [ for (i = [0:len(pv)-1])
           let (v = pv[i],
                vf = [for (face = vertex_faces(i,pf)) vertex(face,newfv)],
                F = centroid(vf),
                R = centroid([for (edge = vertex_edges(i,pe)) vertex(edge,newev)]),
                n = len(vf))
           ( F + 2* R + (n  - 3 )* v ) / n
         ])         
     poly(name=str("S",p_name(obj)),
          vertices= concat(newv,vertex_values(newfv),vertex_values(newev)),                
          faces=newf
      ) 
 ; //end cc

function rcc(s,n=0) =
// multilevel Catmull-Clark
    n == 0
         ? s
         : rcc(cc(s),n-1)
;            
function pyra(obj,h=0.0) =   
// very like meta but different triangles
    let(pe=p_edges(obj),
        pf=p_faces(obj),
        pv=p_vertices(obj))
    let(newv=concat(
          [for (face = pf)               // new centroid vertices
            let(fp=as_points(face,pv))
            [face,centroid(fp) + normal(fp)*h]                                  
          ],
         [for (edge=pe)                // new midpoints
          let (ep = as_points(edge,pv))
            [edge,(ep[0]+ep[1])/2]
         ]))
     let(newids=vertex_ids(newv,len(pv)))
     let(newf=flatten(
         [ for (face=pf) 
           let(centroid=vertex(face,newids))  
           flatten( [for (j=[0:len(face)-1]) 
             let(a=face[j],
                 b=face[(j+1)%len(face)], 
                 z=face[(j-1+len(face))%len(face)],        
                 midab = vertex(distinct_edge([a,b]),newids),
                 midza = vertex(distinct_edge([z,a]),newids))             
             [[midza,a,midab], [midza,midab,centroid]]         
             ])
          ] ))
              
     poly(name=str("y",p_name(obj)),
          vertices= concat(pv, vertex_values(newv)),
          faces=newf
     )
;   // end pyra 
                                 
function ortho(obj,h=0) =  
// each face is replaced with n quadralaterals based on edge midpoints vertices and centroid moved normally
    let (pe=p_edges(obj),
         pf=p_faces(obj),
         pv=p_vertices(obj))
     let(newv=concat(
          [for (face = pf)               // new centroid vertices
            let(fp=as_points(face,pv))
            [face,centroid(fp) + normal(fp)*h]                                  
          ],
         [for (edge=pe)               // new midpoints
          let (ep = as_points(edge,pv))
            [edge,(ep[0]+ep[1])/2]
         ]))
     let(newids=vertex_ids(newv,len(pv)))
     let(newf=
         flatten(
         [ for (face=pf)   
           let(centroid=vertex(face,newids))  
            [for (j=[0:len(face)-1])    
             let(a=face[j],
                 b=face[(j+1)%len(face)],
                 c=face[(j+2)%len(face)],
                 midab= vertex(distinct_edge([a,b]),newids),
                 midbc= vertex(distinct_edge([b,c]),newids))                 
             [centroid,midab,b,midbc]                            
             ]
          ] ))
      
     poly(name=str("o",p_name(obj)),
          vertices= concat(pv, vertex_values(newv)),
          faces=newf
     )
; // end ortho
       
function trunc(obj,fn=[],r=0.25) =
    let (pv=p_vertices(obj),
         pf=p_faces(obj))
               
    let (newv = 
        flatten(
         [for (i=[0:len(pv)-1]) 
          let(v = pv[i])
          let(vf = vertex_faces(i,pf))
          selected_face(vf,fn)        // should drop the _face 
            ? let(oe = ordered_vertex_edges(i,vf))     
              [for (edge=oe)
               let(opv=pv[edge[1]])
                [edge,  v + (opv - v) * r ]
              ]
            : [[[i],v]]
         ]))
     let (newids = vertex_ids(newv))   
     let (newf = 
          concat(    // truncated faces
             [for (face=pf)
              flatten(
              [for (j=[0:len(face)-1])
               let (a=face[j])
               let (nv=vertex([a],newids)) 
               nv != undef
               ?  nv   // not truncated, just renumbered
               :  let(b=face[(j+1)%len(face)],
                      z=face[(j-1+len(face))%len(face)],
                      eab=[a,b],
                      eaz=[a,z],
                      vab=vertex(eab,newids),
                      vaz=vertex(eaz,newids))
                 [vaz,vab]
 
              ])
             ],
          [for (i=[0:len(pv)-1])   //  truncated  vertexes
           let(vf = vertex_faces(i,pf))
           if (selected_face(vf,fn))
              let(oe = ordered_vertex_edges(i,vf))     
              [for (edge=oe)
               vertex(edge,newids)
             ]
          ] ) )    

     poly(name=str("t",p_name(obj)),
          vertices= vertex_values(newv),
          faces=newf
         )
; // end trunc



function quinto(obj) =
    let (pv=p_vertices(obj),
         pf=p_faces(obj),
         pe=p_edges(obj))
               
    let (newv = 
         concat(
         [for (edge = pe) 
          let(ep = as_points(edge,pv))
          let(v= (ep[0] + ep[1])/ 2)
          [edge, v]
         ]
         ,
          flatten([for (face = pf)
           let(ep = as_points(face,pv))
           let(c = centroid(ep))
           [ for (j = [0:len(face) - 1])
             let (v= (ep[j] + ep[(j + 1) % len(face)]  + c) / 3)
             [ [face,j], v]  
           ]])
           
          )
          )
     let (newids = vertex_ids(newv,len(pv)))   
     let (newf = 
          concat(   
          [for (face=pf)    // reduced faces
              [for (j=[0:len(face)-1])
               let (nv=vertex([face,j],newids)) 
               nv 
              ]
              ]

              ,
         
           [for (face=pf)
               for (i = [0:len(face)-1])
               let (v = face[i])
               let (e0 = [face[(i-1+len(face)) % len(face)],face[i]])
               let (e1 = [face[i] , face[(i + 1) % len(face)]])
               let (e0p = vertex(distinct_edge(e0),newids))
               let (e1p = vertex(distinct_edge(e1),newids))
               let (iv0 = vertex([face,(i -1 + len(face)) % len(face)],newids))
               let (iv1 = vertex([face,i],newids))
               [v,e1p,iv1,iv0,e0p]
              
              // [v,e0p,iv0,iv1,e1p]
              ]
          
           ) )   

     poly(name=str("q",p_name(obj)),
          vertices= concat(pv,vertex_values(newv)),
          faces=newf
         )        
; // end quinta    

function propellor(obj,r =0.333) =
    let (pf=p_faces(obj),
         pv=p_vertices(obj),
         pe=p_edges(obj))
    let(newv=
         flatten(      //  2 points per edge
              [for (edge = pe)                 
               let (ep = as_points(edge,pv))
                   [ [ edge,  ep[0]+ r *(ep[1]-ep[0])],
                     [ reverse(edge),  ep[1]+ r *(ep[0]-ep[1])]
                   ]
               ]         
           ) 
         )
     let(newids=vertex_ids(newv,len(pv)))
     let(newf=
         concat(    
            [for (face=pf)   // rotated face
               [ for (j=[0:len(face)-1])
                 let( a=face[j],
                      b=face[(j+1)%len(face)],
                      eab=[a,b],
                      vab=vertex(eab,newids))
                 vab
               ]  
            ]
            ,
            flatten(
             [for (face=pf)   
               [for (j=[0:len(face)-1])
                 let (a=face[j],
                      b=face[(j+1)%len(face)],
                      z=face[(j-1+len(face))%len(face)],          
                      eab=vertex([a,b],newids),
                      eba=vertex([b,a],newids),
                      eza=vertex([z,a],newids))   
                 [a,eba,eab,eza]
               ]
             ])            
           )
       )        
     poly(name=str("p",p_name(obj)),
          vertices= concat(pv, vertex_values(newv)),
          faces=newf
     )         
; // end propellor


function hexpropello(obj) =
// Dave Mccooey's Hexpropello operator
    let (pf=p_faces(obj),
         pv=p_vertices(obj),
         pe=p_edges(obj))
    let(newv=
          concat(
              //  2 points per edge
              flatten(
               [for (edge = pe)                 
                let (ep = as_points(edge,pv)) 
                 [
                  [ [ edge[0], edge[1]], ep[0] + 1/3*(ep[1]-ep[0]) ],
                  [ [ edge[1], edge[0]], ep[1] + 1/3*(ep[0]-ep[1]) ]
                 ]
               ])
              ,   // new rotated inner face vertices
              
                [for (face= pf)
                 let (v = as_points(face,pv))
                 for (i = [0:len(v)-1])
                   [[face,i],   0.2 * v[i] +
                                0.6 * v[(i+1) % len(v)] + 
                                0.2 * v[(i+2) % len(v)]]  
                 
               ]             
                      
           ))
     let(newids=vertex_ids(newv,len(pv)))
     let(newf=
         concat(    
            [for (face=pf)   // rotated face
               [ for (j=[0:len(face)-1])
                 vertex([face,j],newids)
               ]  
            ]
        ,
            flatten(
             [for (face=pf)   
               [for (j=[0:len(face)-1])
                let (a=face[j],
                     b=vertex([face[j],face[(j+1)%len(face)]],newids),
                     c=vertex([face[(j+1)%len(face)],face[j]],newids),
                     d=vertex([face,j],newids),
                     e=vertex([face,(j - 1 +len(face))%len(face)],newids),
                     f =vertex([face[j],face[(j-1+len(face))%len(face)]],newids))      
                 [a, b, c, d, e, f]
               ]
             ]) 
            
           )
       )        
     poly(name=str("h",p_name(obj)),
          vertices= concat(pv, vertex_values(newv)),
          faces=newf
     )         
; // end hexpropellor
        
function chamfer(obj,r=0.333) =
    let (pf=p_faces(obj),
         pv=p_vertices(obj))  
    let(newv=              
          flatten(         //  face inset
          [for(face=pf)
           let(fp=as_points(face,pv),
               c=centroid(fp))
            [for (j=[0:len(face)-1])
               [[face,face[j]], fp[j] + r *(c - fp[j])]
            ]
          ])
        )
            
   let(newids=vertex_ids(newv,len(pv)))
   let(newf =   
         concat(    
            [for (face=pf)      // rotated faces
              [ for (v=face)
                  vertex([face,v],newids)  
              ]  
            ] ,
            flatten(         // chamfered pentagons
             [for (face=pf)   
               [
                 for (j=[0:len(face)-1])
                 let (
                      a=face[j],
                      b=face[(j+1)%len(face)])
                 if(a<b)     // dont duplicate
                 let (edge= [a,b],
                      oppface=face_with_edge([b,a],pf), 
                      oppa=vertex([oppface,a],newids),
                      oppb=vertex([oppface,b],newids),
                      thisa=vertex([face,a],newids),
                      thisb=vertex([face,b],newids))
                      [a,oppa,oppb, b,thisb,thisa]
               ]
             ])            
           ))  
    poly(name=str("c",p_name(obj)),
      vertices=
        concat( 
          [for (v = pv)  (1.0 - r)*v],             // original        
           vertex_values(newv)
         ),
      faces=newf
    ); 
// end chamfer                   
              
              
function ambo(obj) =
  let (pf=p_faces(obj),
       pv=p_vertices(obj),
       pe=p_edges(obj))
         
  let(newv=
       [for (edge = pe)                 
        let (ep = as_points(edge,pv))
            [edge, (ep[0]+ep[1])/2 ] 
        ])
       
  let(newids=vertex_ids(newv))

  let(newf = 
       concat(
         [for (face = pf)
            [for (edge = distinct_face_edges(face))   // old faces become the same with the new vertices
              vertex(edge,newids)
            ]
         ]     
         ,        
        [for (vi = [0:len(pv)-1])        // each old vertex creates a new face, with 
           let (vf= vertex_faces(vi,pf)) // the old edges in left-hand order as vertices
           [for (ve = ordered_vertex_edges(vi,vf))
              vertex(distinct_edge(ve), newids)             
           ]
         ] 
          )) 
                   
  poly(name=str("a",p_name(obj)),
       vertices = vertex_values(newv),  
       faces =  newf
       )
;// end ambo    
       
function snub(obj,h=0.5) = 
   let(pf=p_faces(obj),   
       pv=p_vertices(obj)  )       
       
   let(newv =
          flatten(
             [for (face = pf)   
              let (r = -90 / len(face),
                  fp = as_points(face,pv),
                  c = centroid(fp),
                  n = normal(fp),
                  m =  m_from(c,n) 
                      * m_rotate([0,0,r]) 
                      * m_translate([0,0,h]) 
                      * m_to(c,n))
               [for (i=[0:len(face)-1]) 
                  [[face,face[i]], m_transform(fp[i],m)]
              ]
            ]))
   
   let(newids=vertex_ids(newv))
   let(newf =
         concat(
             [for (face = pf)   
               [for (v = face) 
                  vertex([face,v],newids)
               ]
              ],
               // vertex faces 
             [for (i=[0:len(pv)-1])   
              let (vf=vertex_faces(i,pf))     // vertex faces in left-hand order 
                 [for (of = ordered_vertex_faces(i,vf))
                   vertex([of,i],newids)
                  ] 
             ]
             ,   //  two edge triangles 
             flatten( 
               [for (face=pf)
                flatten( 
                 [for (edge=ordered_face_edges(face))
                  let (oppface=face_with_edge(reverse(edge),pf),
                        e00=vertex([face,edge[0]],newids),
                        e01=vertex([face,edge[1]],newids),                
                        e10=vertex([oppface,edge[0]],newids),                 
                        e11=vertex([oppface,edge[1]],newids) )
                   if (edge[0]<edge[1])
                      [
                         [e00,e10,e11],
                         [e01,e00,e11]
                      ] 
                   ])
                ])     
          ))      
            
   poly(name=str("s",p_name(obj)),
       vertices= vertex_values(newv),
       faces=newf
       )
; // end snub
   
function expand(obj,h=0.5) =                    
   let(pf=p_faces(obj),           
       pv=p_vertices(obj))        
   let(newv=
           flatten(
            [for (face = pf)     //move the whole face outwards
             let (fp = as_points(face,pv),
                  c = centroid(fp),
                  n = normal(fp),
                  m =  m_from(c,n)
                      *  m_translate([0,0,h]) 
                      * m_to(c,n))
             [for (i=[0:len(face)-1]) 
                  [[face,face[i]], m_transform(fp[i],m)]
             ]
             ]))
   let(newids=vertex_ids(newv))
   let(newf =
          concat(
             [for (face = pf)     // expanded faces
               [for (v = face) 
                  vertex([face,v],newids)
               ]
              ],
                 // vertex faces 
              [for (i=[0:len(pv)-1])   
               let (vf=vertex_faces(i,pf))   
                  [for(of=ordered_vertex_faces(i,vf))
                     vertex([of,i],newids)
                  ]
                 ]
               ,       //edge faces                 
               flatten([for (face=pf)
                  [for (edge=ordered_face_edges(face))
                   let (oppface=face_with_edge(reverse(edge),pf),
                        e00=vertex([face,edge[0]],newids),
                        e01=vertex([face,edge[1]],newids),                 
                        e10=vertex([oppface,edge[0]],newids),                
                        e11=vertex([oppface,edge[1]],newids)) 
                   if (edge[0]<edge[1])   // no duplicates
                      [e00,e10,e11,e01] 
                   ]
                ] )           
              ))
                   
   poly(name=str("e",p_name(obj)),
       vertices= vertex_values(newv),
       faces=newf
      )
         
; // end expand

function rexpand(s,h,n=0) =
// used to round edges 
    n == 0
         ? s
         : rexpand(expand(s,h),h *2,n-1)
;
 
function edgequad(obj) =   
// replace each edge with a quad using the centrods of the oposing faces and the edge endpoints                 
   let(pf=p_faces(obj),           
       pv=p_vertices(obj))        
   let(newv=
            [for (face = pf)     // centroids
             let (fp = as_points(face,pv),
                  c = centroid(fp))
              [[face],c]
             ]
             )
   let(newids=vertex_ids(newv,len(pv)))
   let(newf =
          
             [for (face = pf)     // expanded faces
              for (edge=ordered_face_edges(face))
              let (oppface=face_with_edge(reverse(edge),pf),
                   copp=vertex([oppface],newids),
                   c=vertex([face],newids))                 
              if (edge[0]<edge[1])   // no duplicates
                 [edge[0],c,edge[1],copp] 
             ]          
        )
                   
   poly(name=str("e",p_name(obj)),
       vertices= concat(pv,vertex_values(newv)),
       faces=newf
      )
         
; // end edgequad                 
function whirl(obj, r=0.3333, h=0.2) = 
// retain original vertices, add directed edge points  and rotated inset points
//  each edge  becomes 2 hexagons
    let(pf=p_faces(obj),
        pv=p_vertices(obj),
        pe=p_edges(obj))
    let(newv= 
          concat(          
           flatten([for (face=pf)  // centroids
            let (fp=as_points(face,pv))
            let (c = centroid(fp) + normal(fp)*h  )
            [for (i=[0:len(face)-1])
             let (f = face[i])
             let (ep = [fp[i],fp[(i+1) % len(face)]])
             let (mid =  ep[0]+ r *(ep[1]-ep[0])) 
              [[face,f], mid + r  * (c - mid)]
           ]]) ,
           flatten(      //  2 points per edge
              [for (edge = pe)                 
               let (ep = as_points(edge,pv))
                   [ [ edge,  ep[0]+ r *(ep[1]-ep[0])],
                     [ reverse(edge),  ep[1]+ r *(ep[0]-ep[1])]
                   ]
               ]         
           ) 
          ))
    let(newids=vertex_ids(newv,len(pv)))
    let(newf=concat(
         flatten(                        // new faces are pentagons 
         [for (face=pf)   
             [for (j=[0:len(face)-1])
                let (a=face[j],
                     b=face[(j+1)%len(face)],
                     c=face[(j+2)%len(face)],
                     eab=vertex([a,b],newids),
                     eba=vertex([b,a],newids),
                     ebc=vertex([b,c],newids),
                     mida=vertex([face,a],newids),                   
                     midb=vertex([face,b],newids))                   
                [eab,eba,b,ebc,midb,mida]  
            ]
         ]
       )
     ,
        [for (face=pf)   
             [for (j=[0:len(face)-1])
                let (a=face[j])
                vertex([face,a],newids)                  
             ]
         ]            
        )) 
               
    poly(name=str("w",p_name(obj)),
      vertices=  concat(pv, vertex_values(newv)),
      faces= newf,
      debug=newv
      )
; // end whirl
                       
function reflect(obj) =
    poly(name=str("r",p_name(obj)),
        vertices =
          [for (p = p_vertices(obj))
              [p.x,-p.y,p.z]
          ],
        faces=  // reverse the winding order 
          [ for (face =p_faces(obj))
              reverse(face)
          ]
    )
;  // end reflect

function ident(obj) =
          // identity operation 
    obj
;  // end nop 
          
function join(obj) =
    let(name=p_name(obj))
    let(p = dual(ambo(obj)))
    poly(name=str("j",name),
         vertices =p_vertices(p),         
         faces= p_faces(p)
    )
;  // end join 
          
function bevel(obj) =
    let(name=p_name(obj))
    let(p = trunc(ambo(obj)))
    poly(name=str("b",name),
         vertices =p_vertices(p),         
         faces= p_faces(p)
    )
;  // end bevel

function random(obj,o=0.1) =
    poly(name=str("R",p_name(obj)),
         vertices =
          [for (v = p_vertices(obj))
             v + rands(0,o,3)
          ],
        faces= p_faces(obj)
     )
; 

// triangulation operators - need to  be unified 
          
function qt(obj , shortest=1) =
// bitriangulate quadrilateral faces
// use shortest diagonal so triangles are most nearly equilateral
  let (pf=p_faces(obj),
       pv=p_vertices(obj))
           
  poly(name=str("q",p_name(obj)),
       vertices=pv,          
       faces= flatten(
           [for (f = pf)
            
            len(f) == 4
            ? let (p=as_points(f,pv))
              let(comp = norm(p[0]-p[2]) < norm(p[1]-p[3]) ? 1 :0 )
              comp  == shortest
                    ? [ [f[0],f[1],f[2]], [f[0],f[2],f[3]] ]  
                     : [ [f[1],f[2],f[3]], [f[1],f[3],f[0]] ]  
                :  [f]
           ])
       )
;// end qt
        
function pt(obj) =
// tri-triangulate pentagonal faces
  let (pf=p_faces(obj),
       pv=p_vertices(obj))
           
  poly(name=str("u",p_name(obj)),
       vertices=pv,          
       faces= flatten(
           [for (f = pf)
            len(f) == 5
              ?  [[f[0],f[1],f[4]], [f[1],f[2],f[4]], [f[4],f[2],f[3]]]
              :  [f]
           ])
       )
;// end pt

function hq(obj,h=0.2) =  
// each hex face is replaced with 3 quadrilaterals based on alternate vertices and centroid moved normally
    let (pe=p_edges(obj),
         pf=p_faces(obj),
         pv=p_vertices(obj))
     let(newv= 
          [ for (face = pf)               // new centroid vertices
            if (len(face)==6) 
               let(fp=as_points(face,pv))
               [face,centroid(fp) + normal(fp)*h]   
                      
          ])
     let(newids=vertex_ids(newv,len(pv)))
     let(newf=
         flatten(
         [ for (face=pf) 
           len(face)==6 
           ? let(centroid=vertex(face,newids))  
             [for (j=[0:2:len(face)-1])    
             let(a=face[j],
                 b=face[(j+1)%len(face)],
                 c=face[(j+2)%len(face)])                 
             [a,b,c,centroid]                            
             ]
           : [face]
          ] ))
      
     poly(name=str("o",p_name(obj)),
          vertices= concat(pv, vertex_values(newv)),
          faces=newf,debug=newf
     )
; // end hq    
            
function tt(obj) =
// quad triangulate triangular faces 
// requires  all faces to be triangular
  let (pf=p_faces(obj),
       pv=p_vertices(obj),
       pe=p_edges(obj))
  
  let (newv=  // edge mid points 
       [for (edge=pe)
          let (ep = as_points(edge,pv))
             [edge, (ep[0]+ep[1])/2]
        ])
  let(newids=vertex_ids(newv,len(pv)))
  let(newf =
          flatten(
          [for (i =[0:len(pf)-1])
            let(face = pf[i])
            let(innerface = 
                    [vertex(distinct_edge([face[0],face[1]]),newids),
                     vertex(distinct_edge([face[1],face[2]]),newids),
                     vertex(distinct_edge([face[2],face[0]]),newids)
                    ])
           
            concat(
                  [innerface],
                  [for (j=[0:2]) 
                     [face[j],
                      innerface[j],
                      innerface[(j-1 +len(face))%len(face)]
                     ]  
                  ])         
           ]))

  poly(name=str("v",p_name(obj)),
       vertices=
           concat(pv, vertex_values(newv)),  
       faces= newf
       )
;// end tt

function inset_kis(obj,fn=[], r=0.5,h=0) = 
 // as kis but pyramids inset in the face 
    let (pe=p_edges(obj),
         pf=p_faces(obj),
         pv=p_vertices(obj))
     
    let(newv =
         flatten(  
          [for (face = pf)               // new centroid vertices
            let(fp=as_points(face,pv))
            if (selected_face(face,fn))
               let(c=centroid(fp))
               let(ec = c+ normal(fp) * h)     // centroid + a bit of normal  
               concat(  
                      [[face,ec]],      // face centroid
                      [ for (j=[0:len(face)-1])
                         [[face,face[j]], fp[j] + r *(c-fp[j])]
                      ]
                     )
           ]))
   let(newids=vertex_ids(newv,len(pv)))
   let(newf =
          flatten([for (i = [0:len(pf)-1])   
            let(face = pf[i])
            selected_face(face,fn)
              ? flatten(
                 [for (j=[0:len(face)-1])   //  replace face with n quads and n triangles 
                  let (a=face[j],
                       centroid=vertex(face,newids),
                       mida=vertex([face,a],newids),
                       b=face[(j+1)%len(face)],
                       midb=vertex([face,b],newids)) 
                   [ [a,b,midb,mida]  ,   [centroid,mida,midb] ]         
                 ] )
              : [ face ]
         ] ))       
   
    poly(name=str("i",p_name(obj)),
      vertices=  concat(pv, vertex_values(newv)) ,
      faces= newf
    )
;   // end inset_kis
               
function transform(obj,matrix) =
   poly(
       name=str("X",p_name(obj)),
       vertices=transform_points(p_vertices(obj),matrix),
       faces=p_faces(obj));

function place(obj,f) =
// place on nomated face or largest face for printing
   let (face= f == undef ? max_area(face_areas_index(obj)) : p_faces(obj)[f])
   let (points =as_points(face,p_vertices(obj)))
   let (n = normal(points), c=centroid(points))
   let (m=m_from(c,-n))
   transform(obj,m)
;

function orient(obj) =
// ensure faces have lhs order
    poly(name=str("M",p_name(obj)),
         vertices= p_vertices(obj),
         faces = lhs_faces(p_faces(obj),p_vertices(obj))
    );
 
function invert(obj,p) =
// invert vertices 
    poly(name=str("V",p_name(obj)),
         vertices= 
            [ for (v =p_vertices(obj))
              let (n=norm(v))
              v /  pow(n,p)  
            ],
         faces = p_faces(obj)
    );
function skew(obj,a,b) =
   let (m =  [
      [1, 0, 0,  0],
      [tan(a), 1, 0,  0],
      [tan(b), 0, 1,  0],
      [0,  0,  0,  1]
    ]) 
    poly(
       name=str("X",p_name(obj)),
       vertices=transform_points(p_vertices(obj),m),
       faces=p_faces(obj));
            
function openface(obj,outer_inset_ratio=0.2, outer_inset, inner_inset_ratio, inner_inset,depth=0.2,fn=[],min_edge_length=0.01,nocut=0) = 
// upper and lower inset can be specified by ratio or absolute distance
   let(inner_inset_ratio= inner_inset_ratio == undef ? outer_inset_ratio : inner_inset_ratio,
       pf=p_faces(obj),           
       pv=p_vertices(obj))
   let(inv=   // corresponding points on inner surface
       [for (i =[0:len(pv)-1])
        let(v = pv[i])
        let(norms =
            [for (f=vertex_faces(i,pf))
             let (fp=as_points(f,pv))
                normal(fp)
            ])
        let(av_norm = -vsum(norms)/len(norms))
            v + depth * unitv(av_norm)
        ])
                 
   let (newv =   
 // the inset points on outer and inner surfaces
 // outer inset points keyed by face, v, inner points by face,-v-1
         flatten(
           [ for (face = pf)
             if(selected_face(face,fn)
                && min_edge_length(face,pv) > min_edge_length)
                 let(fp=as_points(face,pv),
                     ofp=as_points(face,inv),
                     c=centroid(fp),
                     oc=centroid(ofp))
                 flatten(
                    [for (i=[0:len(face)-1])
                     let(v=face[i],
                         p = fp[i],
                         p1= fp[(i+1)%len(face)],
                         p0=fp[(i-1 + len(face))%len(face)],
                         sa = angle_between(p0-p,p1-p),
                         bv = (unitv(p1-p)+unitv(p0-p))/2,
                         op= ofp[i],
                         ip = outer_inset ==  undef 
                             ? p + (c-p)*outer_inset_ratio 
                             : p + outer_inset/sin(sa) * bv ,
                         oip = inner_inset == undef 
                             ? op + (oc-op)*inner_inset_ratio 
                             : op + inner_inset/sin(sa) * bv)
                     [ [[face,v],ip],[[face,-v-1],oip]]
                    ])
             ])          
           )
   let(newids=vertex_ids(newv,2*len(pv)))
   let(newf =
         flatten(
          [ for (i = [0:len(pf)-1])   
            let(face = pf[i])
            flatten(
              selected_face(face,fn)
                && min_edge_length(face,pv) > min_edge_length
                && i  >= nocut    
              
                ? [for (j=[0:len(face)-1])   //  replace N-face with 3*N quads 
                  let (a=face[j],
                       inseta = vertex([face,a],newids),
                       oinseta= vertex([face,-a-1],newids),
                       b=face[(j+1)%len(face)],
                       insetb= vertex([face,b],newids),
                       oinsetb=vertex([face,-b-1],newids),
                       oa=len(pv) + a,
                       ob=len(pv) + b) 
                  
                     [
                       [a,b,insetb,inseta]  // outer face
                      ,[inseta,insetb,oinsetb,oinseta]  //wall
                      ,[oa,oinseta,oinsetb,ob]  // inner face
                     ] 
                   ] 
                :  [[face],  //outer face
                    [reverse([  //inner face
                           for (j=[0:len(face)-1])
                           len(pv) +face[j]
                         ])
                    ]
                   ]    
               )
         ] ))    
                           
   poly(name=str("L",p_name(obj)),
       vertices=  concat(pv, inv, vertex_values(newv)) ,    
       faces= newf,
       debug=newv       
       )
; // end openface 


function inset(obj,r=0.3, h=-0.1, fn=[]) = 
// upper and lower inset can be specified by ratio or absolute distance
   let(pf=p_faces(obj),           
       pv=p_vertices(obj))    
   let (newv =   
 // the inset points on outer and inner surfaces
 // outer inset points keyed by face, v, inner points by face,-v-1
         flatten(
           [ for (face = pf)
             if(selected_face(face,fn))
             let(fp=as_points(face,pv),
                  c=centroid(fp))
                    [for (i=[0:len(face)-1])
                     let(ip = fp[i] + r * (c-fp[i]) + h *  normal(fp) )                  
                     [ [face,face[i]],ip]
                    ]
             ])          
           )
   let(newids=vertex_ids(newv,len(pv)))
   let(newf =
         flatten(
          [ for (i = [0:len(pf)-1])   
            let(face = pf[i])
            selected_face(face,fn)
              
               ? flatten(concat([for (j=[0:len(face)-1])   // add new face for each edge
                  let (a=face[j],
                       inseta = vertex([face,a],newids),
                       b=face[(j+1)%len(face)],
                       insetb= vertex([face,b],newids))             
                      [[a,b,insetb,inseta]]               
                  ],
                  [[[for (j=[0:len(face)-1]) 
                   let (a=face[j])
                   vertex([face,a],newids)
                  ]]]))
                  
                : [face]
               
         ] ))    
                           
   poly(name=str("n",p_name(obj)),
       vertices=  concat(pv, vertex_values(newv)) ,    
       faces= newf
       )
; // end inset
 
module p_render_text(obj,texts,font,depth,offset,size) {
    
/*
    obj is a polyhedron object created as a conway seed or chain of operation
    texts is an array of strings to be placed on the faces of s
    fint is the definition of the fint used by text()
    depth is the depth of the incised text
    offset is the offset of the strings to control the horizontal alignment
    size is the size of the text - because the defualt solid is about 1 mm in 
        size, and the default font size is 10, this needs to be quite small.
    
   e.g. 
    scale(20) p_render_text(place(O()),["1","2","3","4","5","6","7","8"],"Georgia",0.8,4,0.06);
    
    creates an octahedron with the numbers 1 to 8 on the faces
*/
    
 difference() {
       p_render(obj,faces=true);
       for (i =[0:len(texts)-1])  {
           face=p_faces(obj)[i];
           facep = as_points(face,p_vertices(obj));
           center=centroid(facep);
           normal=normal(facep);
           echo(i,face,facep,center,normal,texts[i]);
           orient_to(center,normal)
               scale(size) rotate([0,0,90])
                   translate([-offset,0,-depth])
                     linear_extrude(height=depth+0.1)
                        text(texts[i],valign="center", font=font);
       }
     }
 }  // end of p_render_text
   

// modulation  
                           
function modulate_points(points) =
   [for(p=points)
       let(s=xyz_to_spherical(p),
           fs=fmod(s[0],s[1],s[2]))
       spherical_to_xyz(fs[0],fs[1],fs[2])
   ];

function xyz_to_spherical(p) =
    [ norm(p), acos(p.z/ norm(p)), atan2(p.y,p.x)] ;

function spherical_to_xyz(r,theta,phi) =
    [ r * sin(theta) * cos(phi),
      r * sin(theta) * sin(phi),
      r * cos(theta)];

function modulate(obj) =
    poly(name=str("W",p_name(obj)),
         vertices=modulate_points(p_vertices(obj)),         
         faces= 
          [ for (face =p_faces(obj))
              reverse(face)
          ]
    )
;  // end modulate

function scale(obj,s)=
   transform(obj,m_scale(s)) ;

// object trimming

module ground(z=200) {
   translate([0,0,-z]) cube(z*2,center=true);
} 

module sky(z=200) {
   rotate([0,180,0]) ground(z);
}

// solid faces



module solid_face(obj,face,thickness) {
     vertices =p_vertices(obj);
     tvertices = [for (p = face) vertices[p]];
     normal=normal(tvertices);
//    upper=vadd(tvertices,thickness/2 *normal) ; 
     upper=tvertices;
/*  
    find dihedral angle at each edge  
    compute offset at each corner of the face
    offset set the point so that the thickness is as given
    nearly there perhaps - works for C() but not for D
  */
    lower = 
        [ for (i=[0:len(face)-1])
          let (edge0= [face[(i-1+len(face))%len(face)], face[i]])
          let (angle0 = dihedral_angle(edge0,p_faces(obj),p_vertices(obj)) /2 )
          let (ed0 = unitv(vertices[edge0[1]]-vertices[edge0[0]]))
          let(v0 = ( ( ed0 + sin(angle0) * normal )*thickness))
          let (edge1= [face[i],face[(i+1)%len(face)]])
          let (angle1 = dihedral_angle(edge1,p_faces(obj),p_vertices(obj)) /2 )
          let (ed1 = unitv(vertices[edge1[0]]-vertices[edge1[1]]))
          let(v1 = ( (ed1 +sin(angle1) * normal)*thickness))
          let (ed=vertices[face[i]] - (v0+v1)/2)
            ed    
        ] ;
     echo(reverse(lower));
     // construct faces
     top = [for(i=[0:len(face)-1]) i];
     bottom = [for(i=[0:len(face)-1]) 2*len(face)-1-i];
     sides = [for(i=[0:len(face)-1])
                [i,(i+1)%len(face),(i+1)%len(face)+len(face),i+len(face)]
             ];
     s_faces = concat([top],[bottom],sides);
     s_vertices= concat(upper,lower);
     echo(s_vertices);
     polyhedron(s_vertices,s_faces);
  };
  
  

module include_solid_faces(obj,face_list,thickness) {
    faces= p_faces(obj);
    for (i = face_list) {
        face=faces[i];
        solid_face(obj,faces[i],thickness);
    }
};

/*
module enclude_solid_faces(obj,face_list,thickness) {
    faces= p_faces(obj);
    for (i = p_faces(obj) {
        if (face=faces[i];
        solid_face(obj,faces[i],thickness);
    }
};

module solid_faces(obj,thickness) {
    faces= p_faces(obj);
    for (i=[0:len(faces) -1]) {
        face=faces[i];
        if (i ==floor($t*25))
            solid_face(obj,faces[i],thickness);
        }
};


*/
