tomverbeure/ball/(list of files, cad)

Other CAD files:
icosahedron/geodesic_6/assembly.FCStd
icosahedron/geodesic_2/test.FCStd
icosahedron/Shell_rev1.FCStd
pcb/3d_models/leds/ws2812d-f8.single_body.FCStd
icosahedron/interlock_trial.FCStd
rev1/ball-inner_left_rev2.amf
rev1/ball-inner_right_rev2.amf
rev1/ball-inner_support_rev1.amf
rev1/Shell_rev1.FCStd
rev1/Inner_rev1.FCStd
rev1/Inner_rev2.FCStd
