tomverbeure/ball/pcb/controller_rev2/controller_rev2.kicad_pcb

## KiCad design pcb/controller_rev2/controller_rev2.kicad_pcb (2023-07-24)

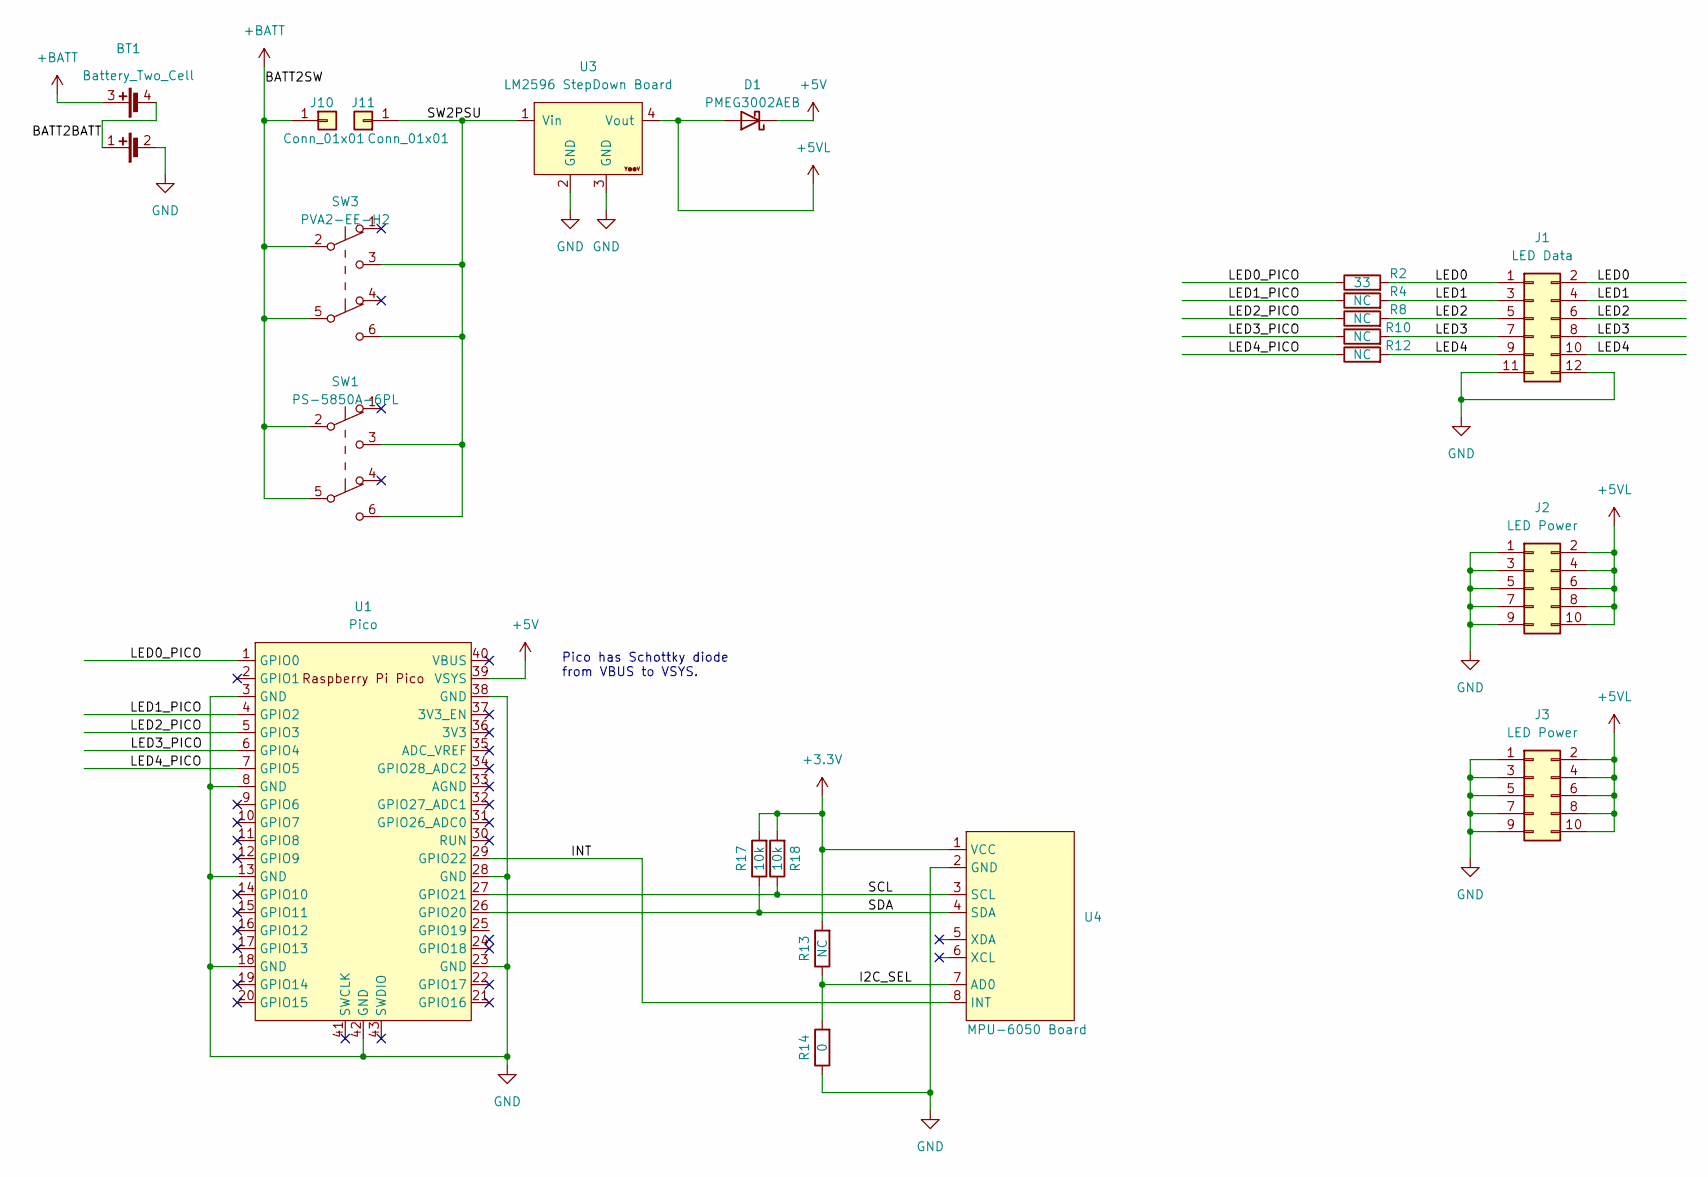
[picture p38: schematic controller_rev2.kicad_sch]

Parts:
BT1: Battery_Two_Cell; battery_holder
D1: PMEG3002AEB; D_SOD-523
J1: LED Data; PinHeader_2x06_P2.54mm_Vertical_SMD
J2, J3: LED Power; PinHeader_2x05_P2.54mm_Vertical_SMD
J10, J11: Conn_01x01; TestPoint_Loop_D3.80mm_Drill2.0mm
R2: 33; R_0603_1608Metric_Pad0.98x0.95mm_HandSolder
R4, R8, R10, R12, R13: NC; R_0603_1608Metric_Pad0.98x0.95mm_HandSolder
R14: 0; R_0603_1608Metric_Pad0.98x0.95mm_HandSolder
R17, R18: 10k; R_0603_1608Metric_Pad0.98x0.95mm_HandSolder
SW1: PS-5850A-6PL; SW_Push_2P2T_Toggle_G_Switch-PS-5850A-6PL
SW3: PVA2-EE-H2; SW_Push_2P2T_Toggle_CK_PVA2xxH2xxxxxxV2
U1: Pico; RPi_Pico_SMD_TH
U3: LM2596 StepDown Board; YAAJ_DCDC_StepDown_LM2596
U4: MPU-6050 Board; MPU-6050_Board_no_screw_holes

Connections:
+3V3: R13.2, R17.2, R18.2, U4.1 (VCC)
+5V: D1.1 (K), U1.39 (VSYS)
+5VL: D1.2 (A), J2.2, J2.4, J2.6, J2.8, J2.10, J3.2, J3.4, J3.6, J3.8, J3.10, U3.4 (Vout)
+BATT: BT1.3 (+), J10.1, SW1.2 (B), SW1.5 (B), SW3.2 (B), SW3.5 (B)
/BATT2BATT: BT1.1 (+), BT1.4 (-)
/I2C_SEL: R13.1, R14.2, U4.7 (AD0)
/INT: U1.29 (GPIO22), U4.8 (INT)
/LED0: J1.1, J1.2, R2.2
/LED0_PICO: R2.1, U1.1 (GPIO0)
/LED1: J1.3, J1.4, R4.2
/LED1_PICO: R4.1, U1.4 (GPIO2)
/LED2: J1.5, J1.6, R8.2
/LED2_PICO: R8.1, U1.5 (GPIO3)
/LED3: J1.7, J1.8, R10.2
/LED3_PICO: R10.1, U1.6 (GPIO4)
/LED4: J1.9, J1.10, R12.2
/LED4_PICO: R12.1, U1.7 (GPIO5)
/SCL: R18.1, U1.27 (GPIO21), U4.3 (SCL)
/SDA: R17.1, U1.26 (GPIO20), U4.4 (SDA)
/SW2PSU: J11.1, SW1.3 (C), SW1.6 (C), SW3.3 (C), SW3.6 (C), U3.1 (Vin)
GND: BT1.2 (-), J1.11, J1.12, J2.1, J2.3, J2.5, J2.7, J2.9, J3.1, J3.3, J3.5, J3.7, J3.9, R14.1, U1.3 (GND), U1.8 (GND), U1.13 (GND), U1.18 (GND), U1.23 (GND), U1.28 (GND), U1.38 (GND), U1.42 (GND), U3.2 (GND), U3.3 (GND), U4.2 (GND)

Notes on the sheet:
Pico has Schottky diode from VBUS to VSYS.

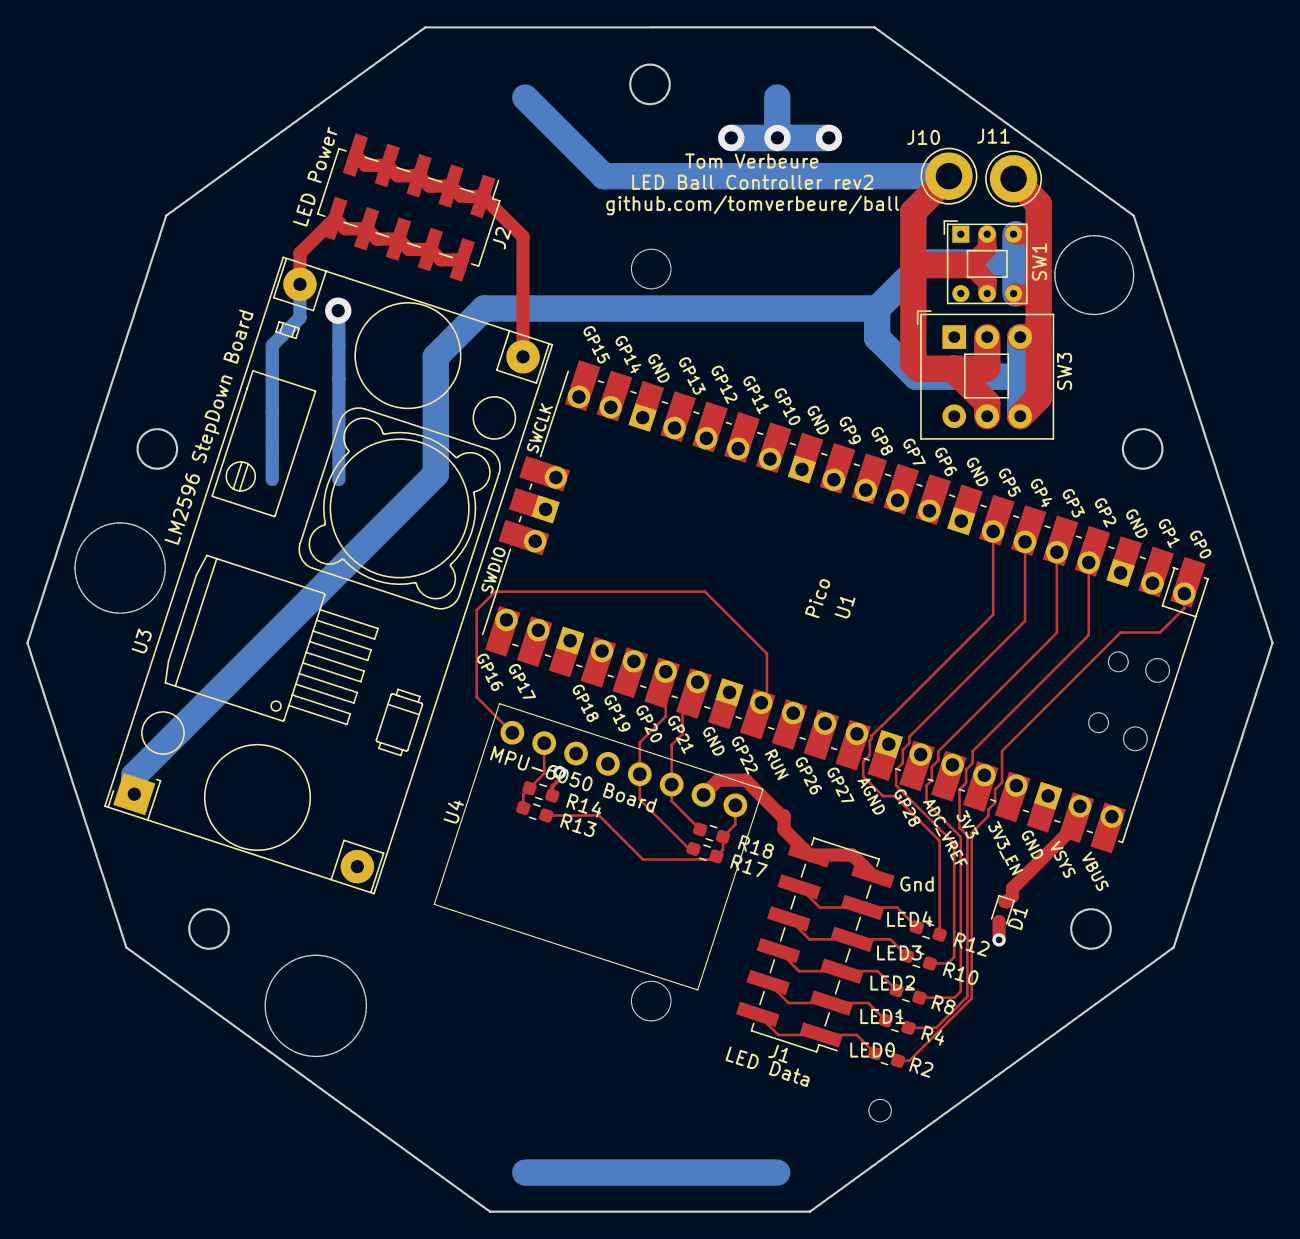
[picture p39: board controller_rev2.kicad_pcb from above]

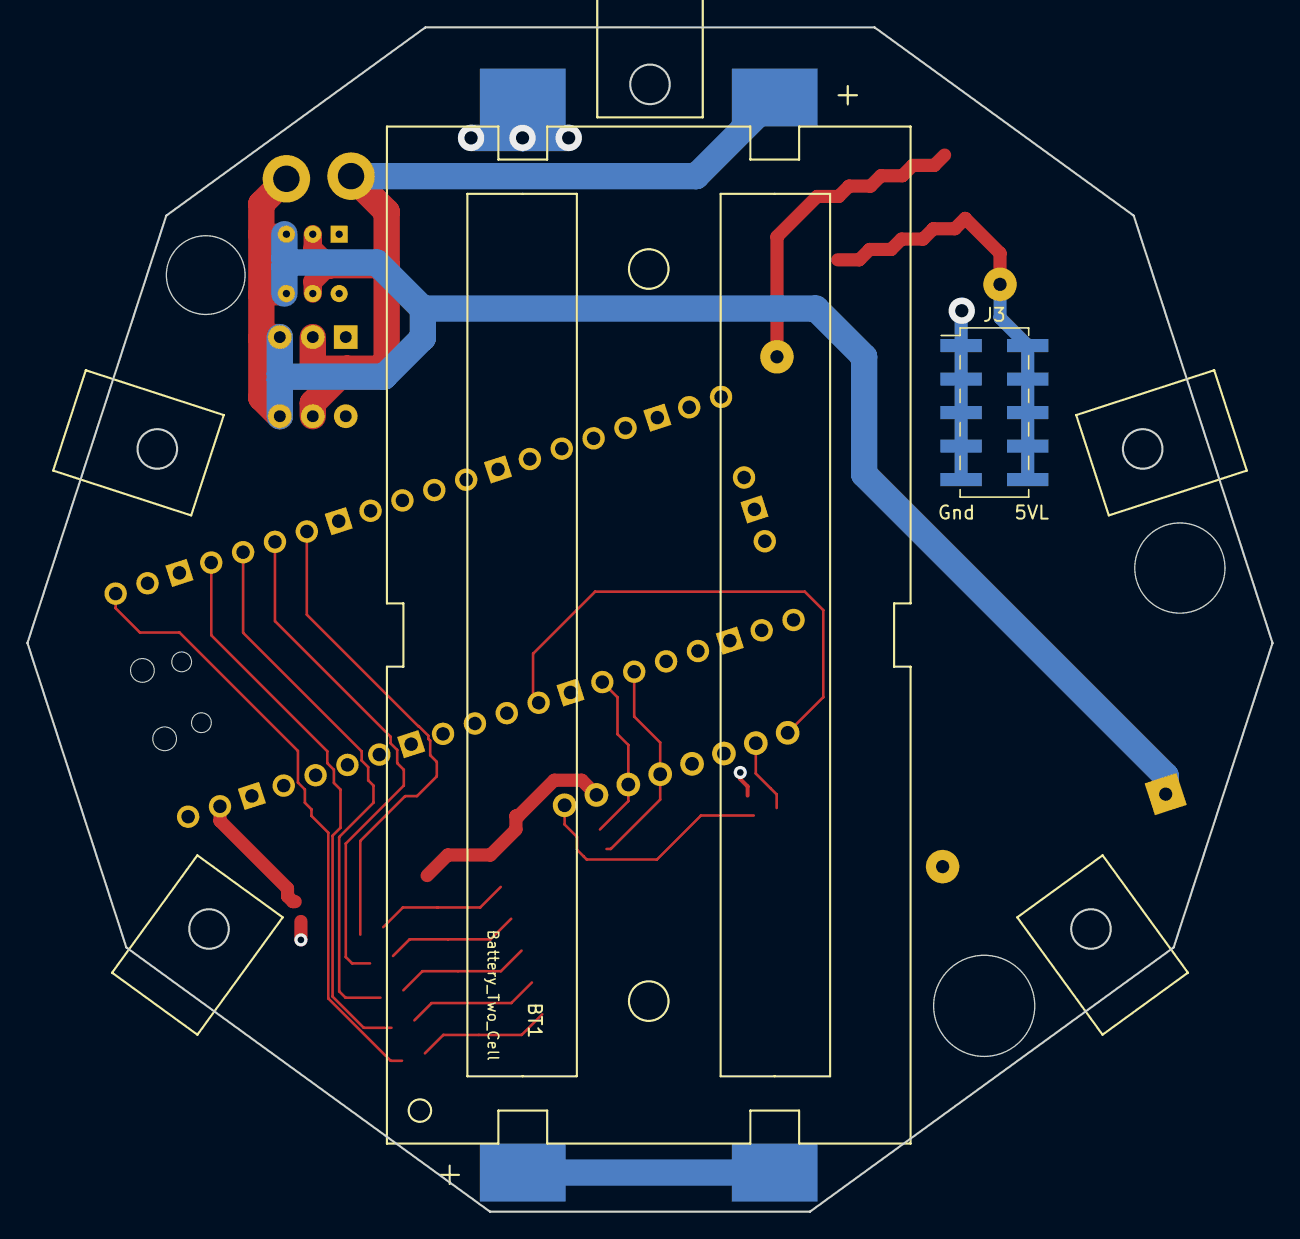
[picture p40: board controller_rev2.kicad_pcb from below]

Board: 4 copper layers, 94.4 x 89.8 mm, 21 parts (2 on the bottom side), 21 nets.
