tomverbeure/ball/pcb/controller/controller.kicad_pcb

## KiCad design pcb/controller/controller.kicad_pcb (2022-05-01)

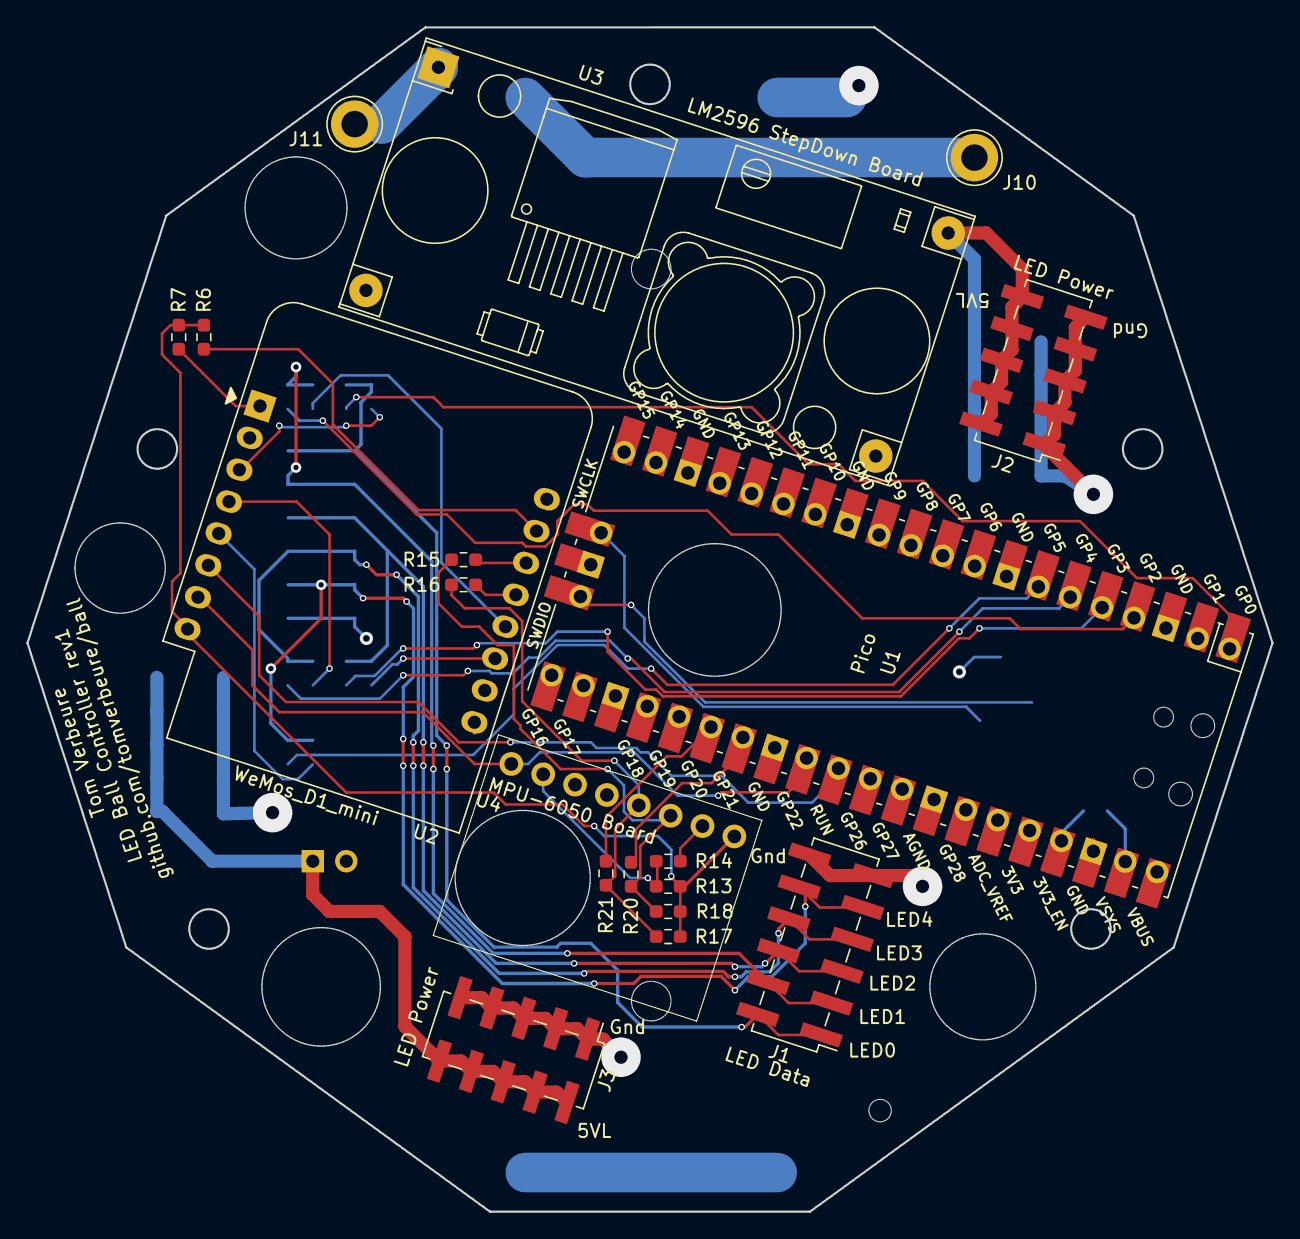
[picture p41: board controller.kicad_pcb from above]

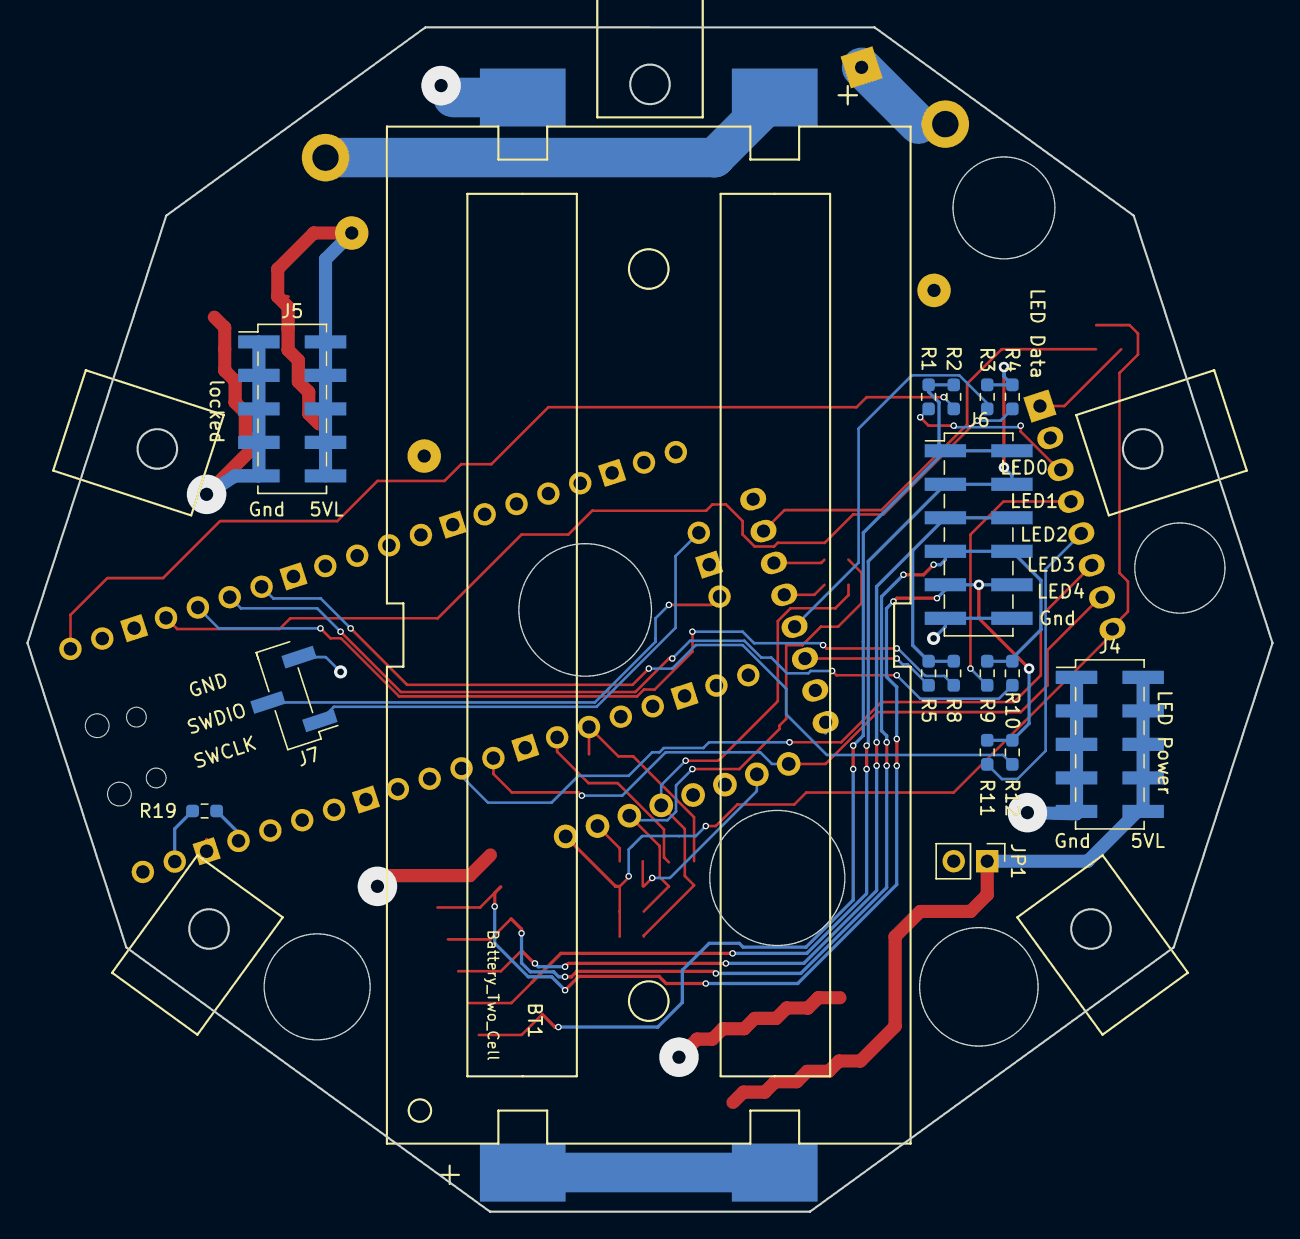
[picture p42: board controller.kicad_pcb from below]

Board: 4 copper layers, 94.4 x 89.8 mm, 36 parts (17 on the bottom side), 37 nets.

Parts:
BT1: Battery_Two_Cell; battery_holder
J1, J6: LED Data; PinHeader_2x06_P2.54mm_Vertical_SMD
J2, J3, J4: LED Power; PinHeader_2x05_P2.54mm_Vertical_SMD
J5: locked; PinHeader_2x05_P2.54mm_Vertical_SMD
J7: Conn_01x03_Male; PinHeader_1x03_P2.54mm_Vertical_SMD_Pin1Left
J10, J11: Conn_01x01; TestPoint_Loop_D3.80mm_Drill2.0mm
JP1: 5V Power; PinHeader_1x02_P2.54mm_Vertical
R1, R2, R3, R4, R5, R6, R7, R8, R9, R10, R11, R12, R13, R14, R17, R18: R; R_0603_1608Metric_Pad0.98x0.95mm_HandSolder
R15, R16, R19, R20, R21: 100K; R_0603_1608Metric_Pad0.98x0.95mm_HandSolder
U1: Pico; RPi_Pico_SMD_TH
U2: WeMos_D1_mini; WEMOS_D1_mini_light
U3: LM2596 StepDown Board; YAAJ_DCDC_StepDown_LM2596
U4: MPU-6050 Board; MPU-6050_Board_no_screw_holes

Connections:
+3V3: R6.1, R7.1, R13.2, R17.2, R18.2, U2.8 (3V3), U4.1 (VCC)
+5V: JP1.2 (B), U1.40 (VBUS), U2.9 (5V)
+5VL: J2.2, J2.4, J2.6, J2.8, J2.10, J3.2, J3.4, J3.6, J3.8, J3.10, J4.2, J4.4, J4.6, J4.8, J4.10, J5.2, J5.4, J5.6, J5.8, J5.10, JP1.1 (A), U3.4 (Vout)
+BATT: BT1.3 (+), J10.1
/BATT2BATT: BT1.1 (+), BT1.4 (-)
/INT: U1.29 (GPIO22), U2.7 (CS/D8), U4.8 (INT)
/LED0: J1.1, J1.2, J6.1, J6.2, R1.2, R2.2
/LED0_ESP: R1.1, U2.3 (D0)
/LED0_PICO: R2.1, U1.1 (GPIO0)
/LED1: J1.3, J1.4, J6.3, J6.4, R3.2, R4.2
/LED1_ESP: R3.1, U2.12 (D3)
/LED1_PICO: R4.1, U1.4 (GPIO2)
/LED2: J1.5, J1.6, J6.5, J6.6, R5.2, R8.2
/LED2_ESP: R5.1, U2.11 (D4)
/LED2_PICO: R8.1, U1.5 (GPIO3)
/LED3: J1.7, J1.8, J6.7, J6.8, R9.2, R10.2
/LED3_ESP: R9.1, U2.4 (SCK/D5)
/LED3_PICO: R10.1, U1.6 (GPIO4)
/LED4: J1.9, J1.10, J6.9, J6.10, R11.2, R12.2
/LED4_ESP: R11.1, U2.5 (MISO/D6)
/LED4_PICO: R12.1, U1.7 (GPIO5)
/PICO_RUN: U1.30 (RUN), U2.6 (MOSI/D7)
/SCL: R15.1, R18.1, R20.1, U4.3 (SCL)
/SDA: R16.1, R17.1, R21.1, U4.4 (SDA)
/SW2PSU: J11.1, U3.1 (Vin)
/SWCLK: J7.1, U1.41 (SWCLK)
/SWDIO: J7.2, U1.43 (SWDIO)
GND: BT1.2 (-), J1.11, J1.12, J2.1, J2.3, J2.5, J2.7, J2.9, J3.1, J3.3, J3.5, J3.7, J3.9, J4.1, J4.3, J4.5, J4.7, J4.9, J5.1, J5.3, J5.5, J5.7, J5.9, J6.11, J6.12, J7.3, R14.1, U1.3 (GND), U1.8 (GND), U1.18 (GND), U1.23 (GND), U1.28 (GND), U1.38 (GND), U1.42 (GND), U2.10 (GND), U3.2 (GND), U3.3 (GND), U4.2 (GND)
unnamed: R6.2, U2.15 (RX)
unnamed: R7.2, U2.1 (~RST)
unnamed: R13.1, R14.2, U4.7 (AD0)
unnamed: R15.2, U2.14 (SCL/D1)
unnamed: R16.2, U2.13 (SDA/D2)
unnamed: R19.1, U1.39 (VSYS)
unnamed: R19.2, U1.37 (3V3_EN)
unnamed: R20.2, U1.27 (GPIO21)
unnamed: R21.2, U1.26 (GPIO20)
