tomverbeure/ball/pcb/triangle/triangle.kicad_pcb

## KiCad design pcb/triangle/triangle.kicad_pcb (2022-04-16)

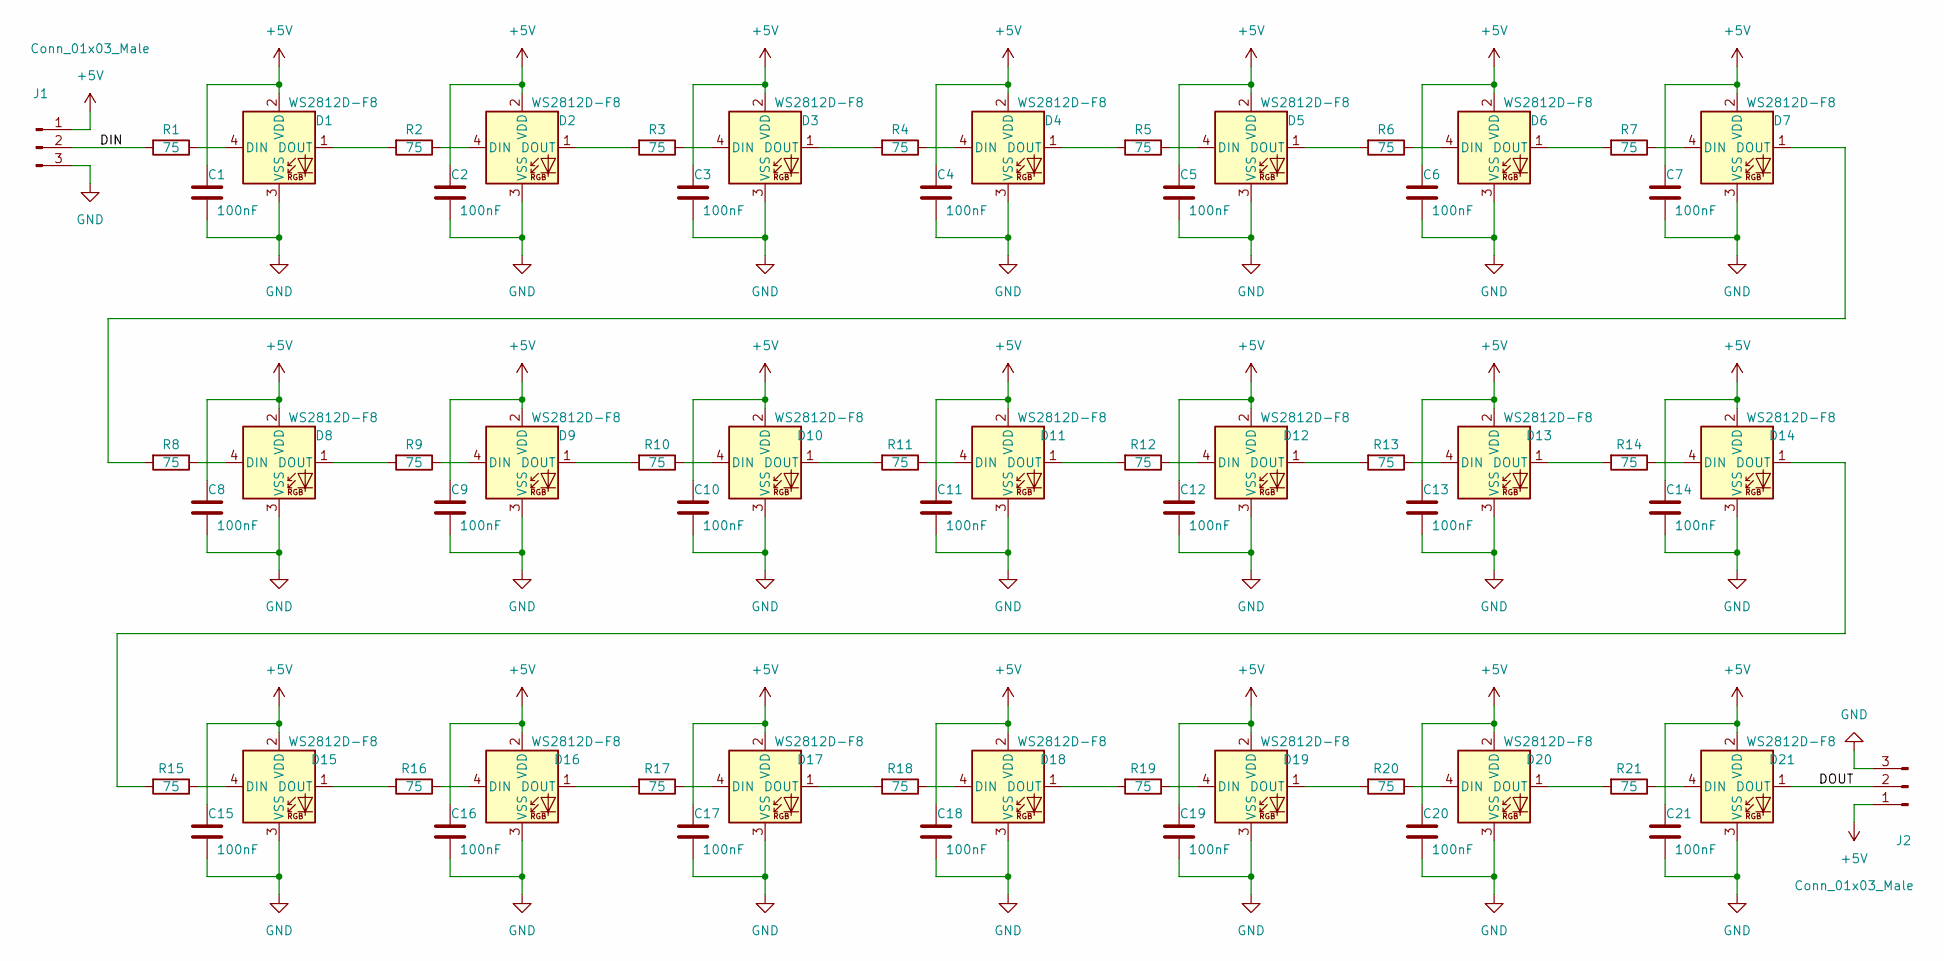
[picture p43: schematic triangle.kicad_sch]

Parts:
C1, C2, C3, C4, C5, C6, C7, C8, C9, C10, C11, C12, C13, C14, C15, C16, C17, C18, C19, C20, C21: 100nF; C_0603_1608Metric
D1, D2, D3, D4, D5, D6, D7, D8, D9, D10, D11, D12, D13, D14, D15, D16, D17, D18, D19, D20, D21: WS2812D-F8; LED_D8.0mm-4
J1, J2: Conn_01x03_Male; PinHeader_1x03_P2.54mm_Vertical
R1, R2, R3, R4, R5, R6, R7, R8, R9, R10, R11, R12, R13, R14, R15, R16, R17, R18, R19, R20, R21: 75; R_0603_1608Metric

Connections:
+5V: C1.1, C2.1, C3.1, C4.1, C5.1, C6.1, C7.1, C8.1, C9.1, C10.1, C11.1, C12.1, C13.1, C14.1, C15.1, C16.1, C17.1, C18.1, C19.1, C20.1, C21.1, D1.2 (VDD), D2.2 (VDD), D3.2 (VDD), D4.2 (VDD), D5.2 (VDD), D6.2 (VDD), D7.2 (VDD), D8.2 (VDD), D9.2 (VDD), D10.2 (VDD), D11.2 (VDD), D12.2 (VDD), D13.2 (VDD), D14.2 (VDD), D15.2 (VDD), D16.2 (VDD), D17.2 (VDD), D18.2 (VDD), D19.2 (VDD), D20.2 (VDD), D21.2 (VDD), J1.1, J2.1
/DIN: J1.2, R1.2
/DOUT: D21.1 (DOUT), J2.2
GND: C1.2, C2.2, C3.2, C4.2, C5.2, C6.2, C7.2, C8.2, C9.2, C10.2, C11.2, C12.2, C13.2, C14.2, C15.2, C16.2, C17.2, C18.2, C19.2, C20.2, C21.2, D1.3 (VSS), D2.3 (VSS), D3.3 (VSS), D4.3 (VSS), D5.3 (VSS), D6.3 (VSS), D7.3 (VSS), D8.3 (VSS), D9.3 (VSS), D10.3 (VSS), D11.3 (VSS), D12.3 (VSS), D13.3 (VSS), D14.3 (VSS), D15.3 (VSS), D16.3 (VSS), D17.3 (VSS), D18.3 (VSS), D19.3 (VSS), D20.3 (VSS), D21.3 (VSS), J1.3, J2.3
unnamed: D1.1 (DOUT), R2.2
unnamed: D1.4 (DIN), R1.1
unnamed: D2.1 (DOUT), R3.2
unnamed: D2.4 (DIN), R2.1
unnamed: D3.1 (DOUT), R4.2
unnamed: D3.4 (DIN), R3.1
unnamed: D4.1 (DOUT), R5.2
unnamed: D4.4 (DIN), R4.1
unnamed: D5.1 (DOUT), R6.2
unnamed: D5.4 (DIN), R5.1
unnamed: D6.1 (DOUT), R7.2
unnamed: D6.4 (DIN), R6.1
unnamed: D7.1 (DOUT), R8.2
unnamed: D7.4 (DIN), R7.1
unnamed: D8.1 (DOUT), R9.2
unnamed: D8.4 (DIN), R8.1
unnamed: D9.1 (DOUT), R10.2
unnamed: D9.4 (DIN), R9.1
unnamed: D10.1 (DOUT), R11.2
unnamed: D10.4 (DIN), R10.1
unnamed: D11.1 (DOUT), R12.2
unnamed: D11.4 (DIN), R11.1
unnamed: D12.1 (DOUT), R13.2
unnamed: D12.4 (DIN), R12.1
unnamed: D13.1 (DOUT), R14.2
unnamed: D13.4 (DIN), R13.1
unnamed: D14.1 (DOUT), R15.2
unnamed: D14.4 (DIN), R14.1
unnamed: D15.1 (DOUT), R16.2
unnamed: D15.4 (DIN), R15.1
unnamed: D16.1 (DOUT), R17.2
unnamed: D16.4 (DIN), R16.1
unnamed: D17.1 (DOUT), R18.2
unnamed: D17.4 (DIN), R17.1
unnamed: D18.1 (DOUT), R19.2
unnamed: D18.4 (DIN), R18.1
unnamed: D19.1 (DOUT), R20.2
unnamed: D19.4 (DIN), R19.1
unnamed: D20.1 (DOUT), R21.2
unnamed: D20.4 (DIN), R20.1
unnamed: D21.4 (DIN), R21.1

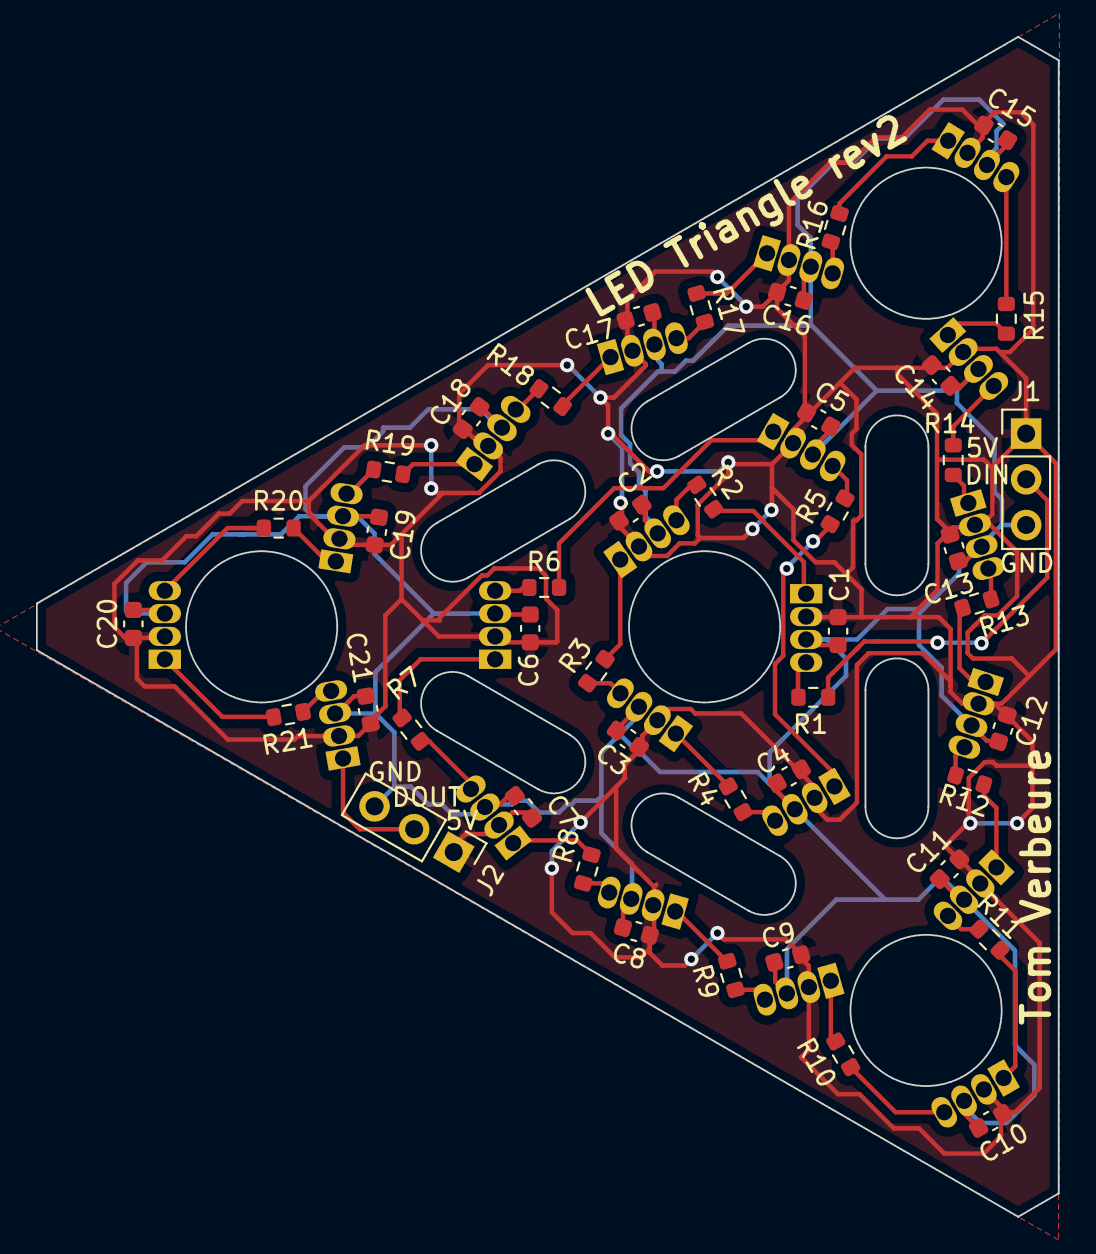
[picture p44: board triangle.kicad_pcb from above]

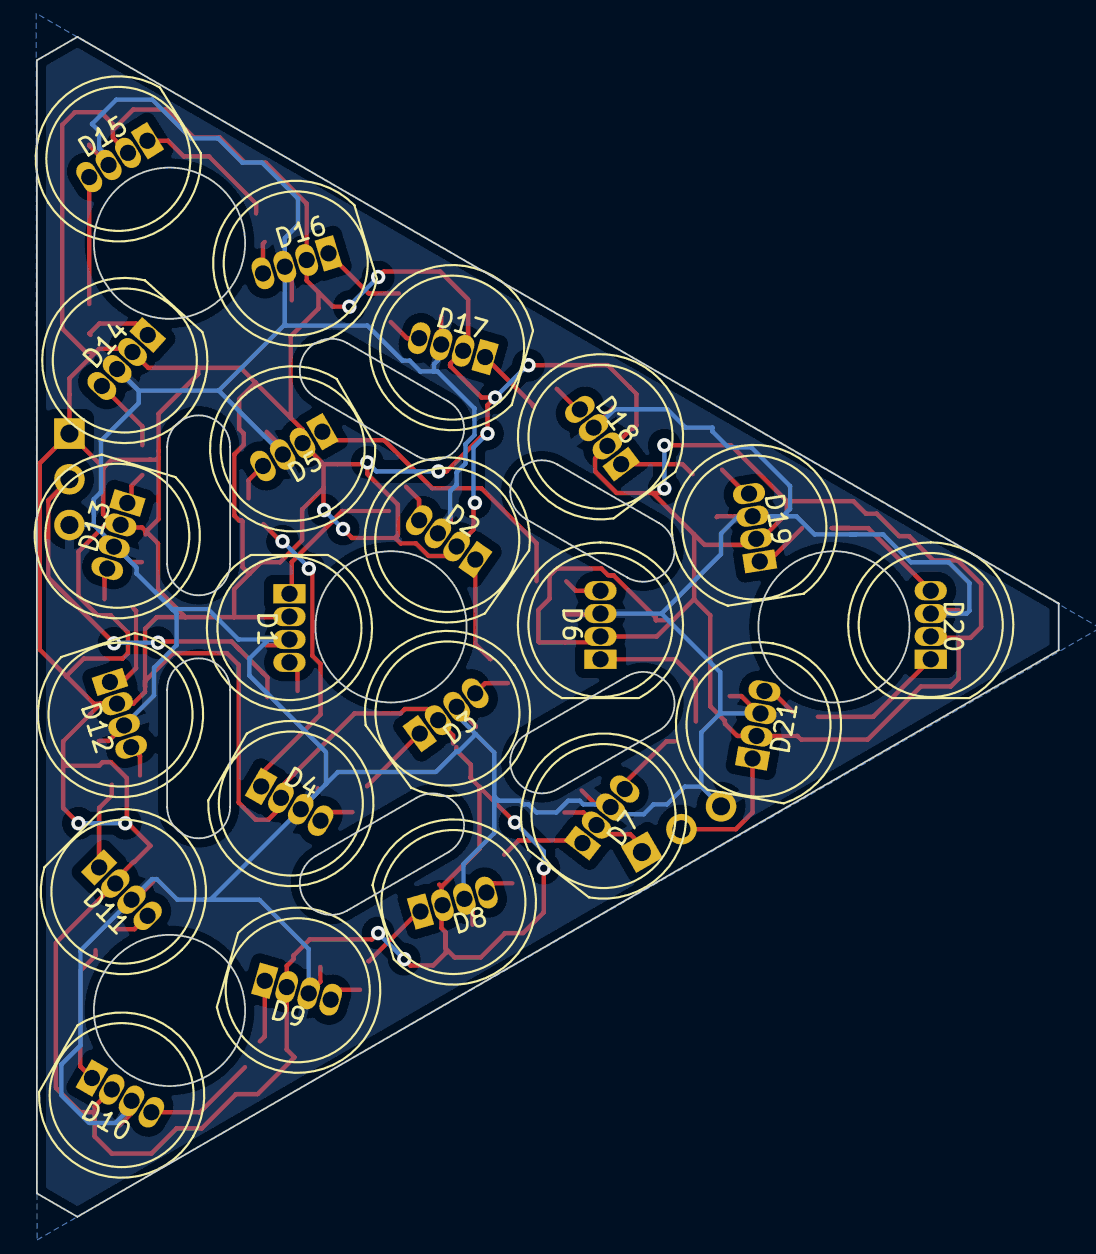
[picture p45: board triangle.kicad_pcb from below]

Board: 2 copper layers, 56.8 x 65.5 mm, 65 parts (21 on the bottom side), 45 nets.
