tomverbeure/ball/rp2040/mpython/ws2812.py

import array, time
from machine import Pin
import rp2
 
# Configure the number of WS2812 LEDs, pins and brightness.
NUM_LEDS = 20 * 21
PIN_NUM = 0
brightness = 0.1
LED_PIN = 25


def led_pattern(phase):
    mask = array.array("I", [0 for _ in range(NUM_LEDS)])

    for i in range(len(ar)):
        led_pos = i % 21
        
        if phase==1:
            if led_pos < 3:
                mask[i] = 1

        elif phase==2:
            if led_pos < 6:
                mask[i] = 1

        elif phase==3:
            if led_pos >= 6:
                mask[i] = 1

    return mask
        
 
@rp2.asm_pio(sideset_init=rp2.PIO.OUT_LOW, out_shiftdir=rp2.PIO.SHIFT_LEFT, autopull=True, pull_thresh=24)
def ws2812():
    T1 = 2
    T2 = 5
    T3 = 3
    wrap_target()
    label("bitloop")
    out(x, 1)               .side(0)    [T3 - 1]
    jmp(not_x, "do_zero")   .side(1)    [T1 - 1]
    jmp("bitloop")          .side(1)    [T2 - 1]
    label("do_zero")
    nop()                   .side(0)    [T2 - 1]
    wrap()
 
 
# Create the StateMachine with the ws2812 program, outputting on Pin(16).
sm = rp2.StateMachine(0, ws2812, freq=8_000_000, sideset_base=Pin(PIN_NUM))
 
# Start the StateMachine, it will wait for data on its FIFO.
sm.active(1)
 
# Display a pattern on the LEDs via an array of LED RGB values.
ar = array.array("I", [0 for _ in range(NUM_LEDS)])
 
def pixels_show():
    dimmer_ar = array.array("I", [0 for _ in range(NUM_LEDS)])
    for i,c in enumerate(ar):
        r = int(((c >> 8) & 0xFF) * brightness)
        g = int(((c >> 16) & 0xFF) * brightness)
        b = int((c & 0xFF) * brightness)
        dimmer_ar[i] = (g<<16) + (r<<8) + b
    sm.put(dimmer_ar, 8)
    time.sleep_ms(10)
 
def pixels_set(i, color):
    ar[i] = (color[1]<<16) + (color[0]<<8) + color[2]
 
def pixels_fill(color, phase):
    mask = led_pattern(phase)

    for i in range(len(ar)):
        if mask[i] == 1:
            pixels_set(i, color)
        else:
            pixels_set(i, (0,0,0))
 
BLACK = (0, 0, 0)
RED = (255, 0, 0)
YELLOW = (255, 150, 0)
GREEN = (0, 255, 0)
CYAN = (0, 255, 255)
BLUE = (0, 0, 255)
PURPLE = (180, 0, 255)
WHITE = (255, 255, 255)
COLORS = (RED, YELLOW, GREEN, CYAN, BLUE, PURPLE, WHITE)
 
while True:
    for color in COLORS:
        for phase in range(0,4):
            pixels_fill(color, phase)
            pixels_show()
            time.sleep(0.2)
