tomverbeure/ball/rp2040/c/ws2812/led_coords.h

const t_led_coord led_coords[420] = {
    // Triangle: 0
    {-0.8158, 0.4197, 0.4026},  // 0
    {-0.8684, 0.2566, 0.4276},  // 1
    {-0.8947, 0.0868, 0.4408},  // 2
    {-0.8947, -0.0868, 0.4408},  // 3
    {-0.8684, -0.2566, 0.4276},  // 4
    {-0.8158, -0.4197, 0.4026},  // 5
    {-0.8987, 0.3513, 0.2671},  // 6
    {-0.9447, 0.1789, 0.2803},  // 7
    {-0.9592, -0.0000, 0.2855},  // 8
    {-0.9447, -0.1789, 0.2803},  // 9
    {-0.8987, -0.3513, 0.2671},  // 10
    {-0.9553, 0.2737, 0.1237},  // 11
    {-0.9882, 0.0921, 0.1276},  // 12
    {-0.9882, -0.0921, 0.1276},  // 13
    {-0.9553, -0.2737, 0.1237},  // 14
    {-0.9829, 0.1868, -0.0237},  // 15
    {-1.0013, -0.0000, -0.0237},  // 16
    {-0.9829, -0.1868, -0.0237},  // 17
    {-0.9816, 0.0947, -0.1697},  // 18
    {-0.9816, -0.0947, -0.1697},  // 19
    {-0.9513, 0.0000, -0.3105},  // 20
    // Triangle: 1
    {-0.6513, -0.6461, 0.4026},  // 21
    {-0.5118, -0.7461, 0.4276},  // 22
    {-0.3592, -0.8237, 0.4408},  // 23
    {-0.1947, -0.8776, 0.4408},  // 24
    {-0.0237, -0.9053, 0.4276},  // 25
    {0.1474, -0.9053, 0.4026},  // 26
    {-0.6118, -0.7461, 0.2671},  // 27
    {-0.4618, -0.8434, 0.2803},  // 28
    {-0.2961, -0.9132, 0.2855},  // 29
    {-0.1224, -0.9539, 0.2803},  // 30
    {0.0566, -0.9632, 0.2671},  // 31
    {-0.5553, -0.8237, 0.1237},  // 32
    {-0.3934, -0.9118, 0.1276},  // 33
    {-0.2184, -0.9684, 0.1276},  // 34
    {-0.0355, -0.9934, 0.1237},  // 35
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
    { 399, 401, 109, 406, 405, 110},
    { 402, 400, 407, 108, 406, 109},
    { 401, 403, 407, 107, 408, 106},
    { 404, 402, 106, 408, 409, 105},
    { 409, 403, 378, 105, 384, 106},
    { 399, 410, 406, 325, 400, 320},
    { 405, 407, 411, 410, 400, 401},
    { 408, 406, 412, 411, 402, 401},
    { 407, 409, 412, 413, 403, 402},
    { 404, 413, 408, 384, 403, 378},
    { 405, 414, 406, 411, 329, 325},
    { 415, 414, 406, 412, 407, 410},
    { 415, 416, 408, 411, 407, 413},
    { 416, 409, 408, 412, 389, 384},
    { 417, 410, 411, 415, 332, 334},
    { 417, 418, 411, 412, 414, 416},
    { 413, 418, 412, 415, 393, 396},
    { 419, 414, 415, 334, 418, 335},
    { 416, 419, 415, 396, 417, 398},
    { 417, 418, 335, 398, 334, 396}
};
