tomverbeure/ball/rp2040/c/ws2812/particles.h

#ifndef PARTICLES_H
#define PARTICLES_H

#include <stdio.h>
#include <stdlib.h>

#include "general.h"
#include "pattern.h"

class Particles : public Pattern
{
    public:

    uint8_t cur_values[NUM_PIXELS];

    void init();
    int calc_next_frame(t_vec gravity);
    void render(t_color led_buffer[NUM_PIXELS]);
};



#endif
