tomverbeure/ball/(commit log)

2019-09-07 Add hole.
2019-09-07 Move icosahedron experiment to its own directory.
    [Icosahedron.scad, TruncatedGreatIcosahedron-solid.scad, buckyball.scad]
2019-09-08 4 top cut boundaries.
2019-09-08 Move led rendering to python.
2021-12-22 Assembly with uneven holes. (Use as bad example 1.)
    [assembly2.FCStd, isocahedron.FCStd, test.FCStd]
2021-12-22 Move around.
    [assembly2.FCStd, test.FCStd]
2021-12-22 10 LEDs per face, spread roughly evenly.
    [assembly2.FCStd, test.FCStd]
2022-01-08 Various trials.
    [base.FCStd, frame.FCStd, test-Body002Box008.amf, test.FCStd, ws2812d-f8.FCStd]
2022-01-09 Radiating screw holes.
    [base.FCStd]
2022-01-18 Start of script.
    [assembly.FCStd, base.FCStd]
2022-01-20 Calculate LED locations
2022-01-20 Create LED holes.
2022-01-21 Cut sphere into rounded tetrahedron.
2022-01-22 Rotate LED leads gap. WIP.
2022-01-23 Rotate main triangle to be orthogonal to X axis.
2022-01-24 Simplify LED rotation.
2022-01-24 LED shaft parameters.
2022-01-24 Use pcb_plane_offset everywhere.
2022-01-24 Add screw insert holes.
2022-01-31 Add PCB.
2022-03-01 Freecad to Kicad instructions
2022-03-01 Add extra screw insert in center.
2022-03-03 interlock trial.
    [interlock_trial.FCStd]
2022-03-03 Icosahedron with export to PCB.
    [isocahedron_pcb_export.FCStd]
2022-03-03 Triangle PCB.
    [triangle.kicad_pcb, triangle.kicad_sch, triangle.step]
2022-03-03 Magnet holes.
    [interlock_trial-BodyPocket002.amf, interlock_trial.FCStd]
2022-03-04 Add magnet holes on 1 side.
2022-03-04 Fix magnet radius.
2022-03-04 Magnet holes on 3 sides.
2022-03-05 Magnets and alignments on all 3 sides.
2022-03-05 Move corner insert holes a bit outside and change to magnet holes.
2022-03-05 Ring assembled.
2022-03-05 Circle and Ring+Circle assembly
    [Shell_and_PCB_complete.FCStd]
2022-03-06 Add inner piece feet. Add additional PCB holes.
2022-03-06 Parameterize PCB gap.
2022-03-08 Create attach point.
    [Shell_and_PCB_battery_test.FCStd]
2022-03-10 Make slightly larger. Adjust magnet sizes.
2022-03-10 Adjust insert holes a bit towards the center.
2022-03-13 Split PCB one large PCB gap into 2 smaller gaps.
    [triangle-B_Cu.gbr, triangle-B_Mask.gbr, triangle-B_Paste.gbr, triangle-B_Silkscreen.gbr, triangle-Edge_Cuts.gbr, triangle-F_Cu.gbr, triangle-F_Mask.gbr, triangle-F_Paste.gbr]
2022-03-13 Shell rev1 files.
    [CE3PRO_ball-2x_shell_full_brim.3mf, Shell_rev1.FCStd, ball-shell_full.amf]
2022-03-27 Move triangle v1 gerbers to v1 directory.
    [triangle-B_Cu.gbr, triangle-B_Mask.gbr, triangle-B_Paste.gbr, triangle-B_Silkscreen.gbr, triangle-Edge_Cuts.gbr, triangle-F_Cu.gbr, triangle-F_Mask.gbr, triangle-F_Paste.gbr]
2022-03-27 Triangle PCB v2.
    [triangle-B_Cu.gbr, triangle-B_Mask.gbr, triangle-B_Paste.gbr, triangle-B_Silkscreen.gbr, triangle-Edge_Cuts.gbr, triangle-F_Cu.gbr, triangle-F_Mask.gbr, triangle-F_Paste.gbr]
2022-03-27 shell gcode, assembly experiments.
    [CE3PRO_ball-2x_shell_full_brim.3mf, PCB_export.FCStd, Shell_rev1.FCStd, assembly_a2plus.FCStd, assembly_a4.FCStd, ball-1x_shell_full_brim.3mf, ball-2x_shell_full_brim.3mf]
2022-03-28 Inner piece, rev1.
    [Inner_rev1.FCStd, ball-inner_support_rev1.amf]
2022-03-30 Inner center/left/right pieces
    [Inner_rev2.FCStd, ball-inner_center_rev2.amf, ball-inner_left_rev2.amf, ball-inner_right_rev2.amf]
2022-04-04 Battery holder.
    [battery_holder.FCStd, battery_holder.step]
2022-04-16 LED & battery holder fixes.
    [battery_holder.FCStd, battery_holder.step, triangle.kicad_pcb, ws2812d-f8.FCStd, ws2812d-f8.master_sketch.FCStd, ws2812d-f8.single_body.FCStd]
2022-04-17 Add Raspberry Pico to library.
2022-04-17 Link to Pico.wrl.
2022-04-17 Board with only RPico.
    [controller.kicad_pcb, controller.kicad_sch]
2022-04-17 LM2596 board in FreeCAD (WIP)
2022-04-30 Move battery holder model.
2022-05-01 Checkpoint after controller gerbers.
    [Inner_rev3.FCStd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]
2022-06-12 Single sphere element with LEDs cycling color.
2022-06-12 Drive 420 LEDs with rotating pattern.
2022-06-16 Add little spheres where the LED coordinates are.
2022-06-20 Dump led coordinates to json file.
2022-06-26 Add C ws2812 code, based on pico-examples.
2022-07-06 Preparation for LED coordinate system.
2022-07-06 LEDs are correctly mapped to virtual coordinate.
2022-07-06 Refactor LED nr calculation.
2022-07-22 Dump LED positions to file.
2022-11-05 Loop between different effects. Disable broken RGB sphere.
    [main.cc]
2023-05-22 Controller rev2.
    [controller_rev2.kicad_pcb, controller_rev2.kicad_sch]
